li59533/JunYue_Lora/doc/君悦lora_李阳提供文档_20200513/君悦LoRaL100_产品说明书_20200508.docx

文档编号
版本号 | V0.1.0
归档部门

无线温振传感器-L100

【产品说明书】

李 阳

二〇二〇年五月

## 变更记录

序号 | 日期 | 作者/修改者 | 描述 | 版本号
1 | 2020-05-08 | 李阳 | 创建 | 0.0.1
2
3

# 1.引言

## 1.1编写目的

为保证正确使用本产品，要求用户在使用前了解掌握有关正确的安装和操作方法，若阅读本说明后仍有其他疑问请致电本公司技术人员。

## 1.2读者对象

产品实际用户、销售等

## 1.3术语和缩写

术语和缩写 | 解释 | 备注

## 1.4参考资料

参考资料 | 备注

# 2.产品概述

L100无线振动传感器，是一种内置IEPE电路、MEMS电路、温度测量电路，同时提供三轴振动数据的传感器。敏感原理利用无源压电晶体的正压电效应，敏感结构采用先进的剪切结构，通过IEPE电路将压电晶体的输出电荷转换为与振动量成正比的低阻电压信号，经高精度AD采样后，CPU将测得的数据经过算法计算后，通过Lora发送给上位机端。上位机端采集数据的显示与分析。

由于该产品体积小、刚度大、频响宽，电压灵敏度高、寿命长、低阻抗、密封性好、安装可靠、接线使用方便，敏感无源等一系列优点，可广泛应用与航天航空、轨道交通、建筑桥梁、风电监测等工业领域的振动冲击测量。

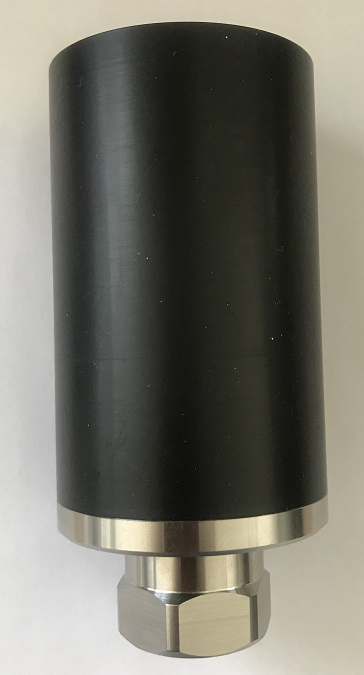
[picture p1: figure]

图1.产品全貌

# 3.产品基本信息

产品名称： 无线温振三轴传感器（Lora）

产品型号： L100

通讯方式： LoRa

默认出厂配置：

休眠时间：60s

SN：L10031001100

有效发送次数：11000次。（4400mAh锂亚电池）

用途：

监测数据：

- 振动加速度有效值(主<500m/s2 ,辅<100m/s2 )
- 振动速度有效值(<35mm/s)
- 振动位移有效值(<560um)
- 峭度(<50)
- 包络(<10)
- 传感器工作温度

性能：

传感器：

- 时域信息存储采样率：16.384KHz
- 采样精度：±0.07m/s2（主轴）±0.15m/s2（辅轴）
- 读取周期：1s
- 通讯协议：私有协议（见通讯协议文档）
- 工作温度：-40℃ to +70℃
- 存储温度：-40℃ to + 85℃
- 待机电流：<10uA
- 工作电流：35mA（采集），150mA（发送）

电源：

  - 工作电压：DC3.6V（锂亚电池）
  - 电池续航能力：发送间隔30min，工作239天（25℃）
  - 锂亚电池说明：
    - 品牌：日月牌锂电池
    - 生产制造商：武汉瀚兴日月电源有限公司
    - 型号：ER14505M（一次锂亚硫酰氯功率型电池3.6V）
    - 标称电量：2.2Ah（两节并联4.4Ah）
    - 标称电压：3.6V
    - 最大连续放电电流：500mA
    - 最大脉冲放电电流：1000mA

振动传感器：

  - 防护等级：IP65
  - 振动量程：±50g（主轴）、±10g（辅轴）
  - 频响：1Hz~5000Hz（主轴）、1Hz~1000Hz（辅轴）
  - 灵敏度：30mv/g（主轴）、132mv/g（辅轴）
  - 隔离方式：与地隔离
  - 传感器类型：IEPE、MEMS

温度传感器：

  - 温度量程：-50~150℃
  - 测温精度：±0.5℃

LoRa传输：

工作频率：470MHz

最大发射功率：20dBm

协议：LoRaWAN

通讯距离：1.5Km（开阔环境）

# 4.产品原理

## 4.1监测单元

主轴振动监测：

L100无线传感器的压电式敏感元件采用P5压电陶瓷晶体，晶体材料在承受一定方向的应力变形时，其极化面会产生与应力相应的电荷。

则有： Q= d F

其中Q为电荷量，d 为压电晶体的压电常数，F为作用力，是施加在晶体上的惯性作用力，根据牛顿第二定律 ：

F=m·a

其中m为惯性质量，a为感受到的加速度

将此公式带入上式，则 Q= d· m·a

在压电晶体的两端输出与加速度成正比的高阻的电荷信号。当压电敏感元件电极表面聚集电荷时，它又相当于一个以压电材料为电介质的电容器。其等效电路如下：

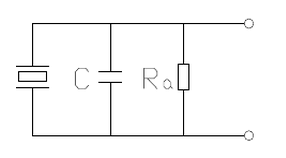
[picture p2: figure]
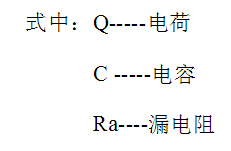
[picture p3: figure]

图2.等效电路

根据以上等效电路，其输出是无源的电荷量。由于压电敏感元件的内阻很高，且信号微弱，需经过二次仪表进行阻抗变换与放大处理后再进入AD采样。通过在无线传感器内部内置IEPE前置电路，将高阻的电荷信号转换成低阻的电压信号，再由内置的CPU采样处理（经滤波、抽样、积分等处理后可测得加速度、速度、位移参量），处理完成后通过LoRa快速发出。

辅轴振动监测：

采用高精度加速度MEMS传感器，进行相对于地面的振动加速度原始数据。经过滤波电路，进入高速AD采样。

温度监测：

采用脉冲式温度传感器采集L100的温度。

## 4.2传输单元

LoRa传输

## 4.3 指示灯单元

- 上电，1s周期慢闪3次。
- 上电回有1min的配置时间，在上电后15s时，会500ms周期快闪3次，提醒此时传感器还有45秒配置时间。
- 休眠前2s会常亮。
- 发送成功，会100ms周期快闪3次。

重发机制：若发送未响应，则会触发重发。

# 5.产品构造与规格

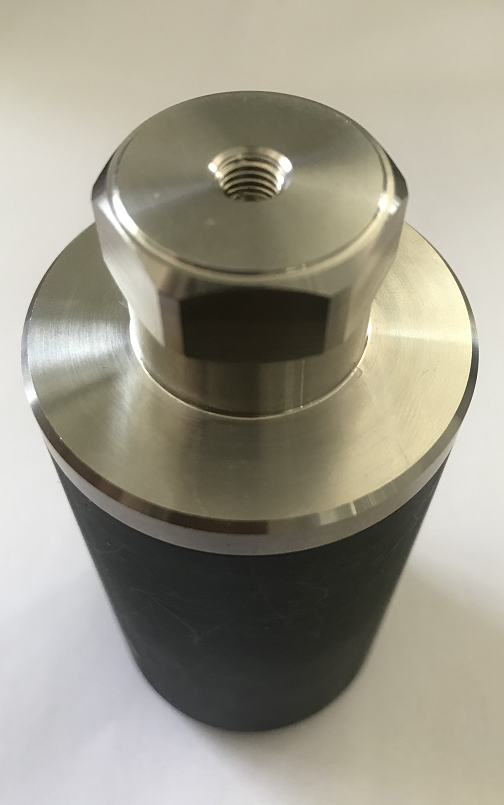
[picture p4: figure]

图3.传感器全貌

尺寸：高150mm，直径50mm

重量：Xg

# 6.产品安装

无线传感器敏感轴（Z轴）为沿垂直于安装底面的方向。正极性是指从安装面指向传感器本体方向收到作用时输出一正极信号，反之输出一负极信号则判断为负极性。

在选择安装方式时要充分考虑每种方法在安装位置、安装附件、环境温度、牢固度等多方面的优缺点，尤其要关注不同的安装方式对加速度传感器的高频性能的影响。

下图为六种主要的安装方法对压电传感器频响产生的典型效果。

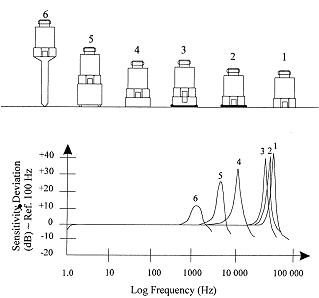
[picture p5: figure]

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
低频性能不受安装方式的影响。截至频率完全取决与内置电路的低频截至频率 。当交流信号耦合时且配接仪表的数量阻抗低于1MΩ时，低频将收到影响。

## 6.1 螺栓安装

由于传感器安装底端面光洁度、平面度均＜1.6μm，希望被测构件与传感器结合面应提高光洁度及平整度，要保证安装面及构件的结合面刚性接触，才能有效地保证达到传感器出厂时的频响特性，因此在被测构件的安装面处，打磨平一块面积约为传感器安装面的1.1倍大，此处的粗糙度要求最好小于0.63um，并清理干净。

在此安装面处图上一层薄薄的油脂，如硅脂等以改善贴合性能。

传感器在底端面有一1/4-28（垂直度＜0.1mm 深6mm）的螺孔。使用时应先将螺栓旋入传感器底部，然后再将传感器安装到被测构件上。建议使用扭矩扳手拧紧传感器，防止出现安装不紧或扭矩过大损坏螺栓或传感器。

## 6.2 胶粘安装

胶粘一般属于临时性安装，或因工件表面无法使用螺栓安装时选用的一种安装方法，一般对高频响应会有影响，对低频影响不大。建议做试样后确定使用频率范围。

可以选用蜂蜡，硅脂等做临时性贴合安装，而采用双组分的环氧胶或快干胶做较为永久性的安装。

胶粘可以通过将传感器先安装在一个转接的安装座上，也可直接安装到工件表面。

## 6.3 磁座安装

磁座安装提供了一种最便捷的快速安装方法，通常在设备状态监控、点检仪以及振动趋势监测等场合。选择合适的磁座和处理好安装面对高频性能是非常关键的。不好的安装会导致高频性能下降50%。

扁平磁座适于光滑平整的表面，而双脚磁座适于有曲面的如管道或电机机壳等安装环境。

在没有磁性或粗糙的安装条件下，建议用户先用焊接或胶粘等方法在测试表面安装一个有光洁平整安装面的钢座，保证测试达到预期效果。

磁座安装时，应禁止磁座安装底面正面直接吸到工件测试表面，防止吸合瞬间产生很大的冲击加速度损坏传感器。而是要先以一点接触安装面后再轻轻转动传感器使安装面贴合。如下图所示。

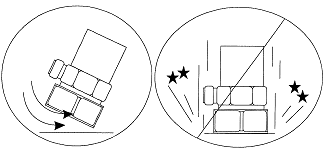
[picture p6: figure]

## 6.4 探针安装

大部分情况下不推荐使用这种安装方式，其在低于5Hz或高于1KHz的情况下均存在极大的误差。仅用于空间受限的设备状态监控场合。

# 7.软件配置

本产品交互报文采用“联能传感器私有协议V1.0.0”，可使用专业软件进行配置。详细配置操作参阅“无线温振传感器配置V1.0.0”。

简要说明：

1. 产品上电1分钟后进入低功耗模式。在存活阶段可用相应的配置软件进行参数配置，如图所示。

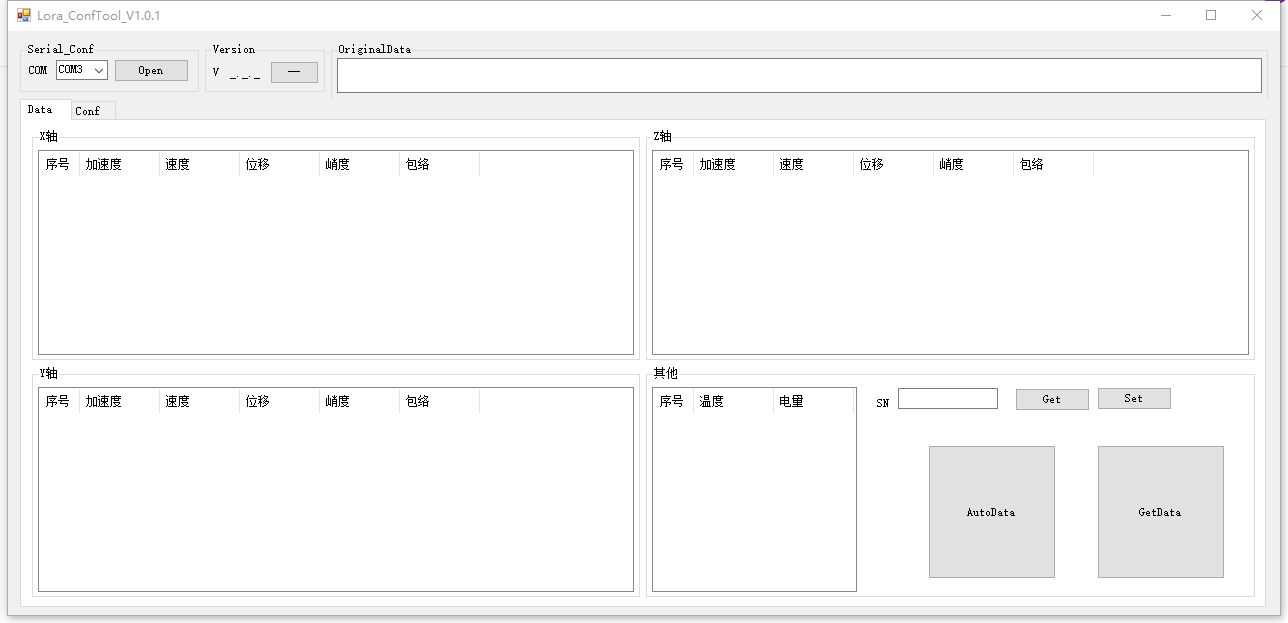
[picture p7: figure]
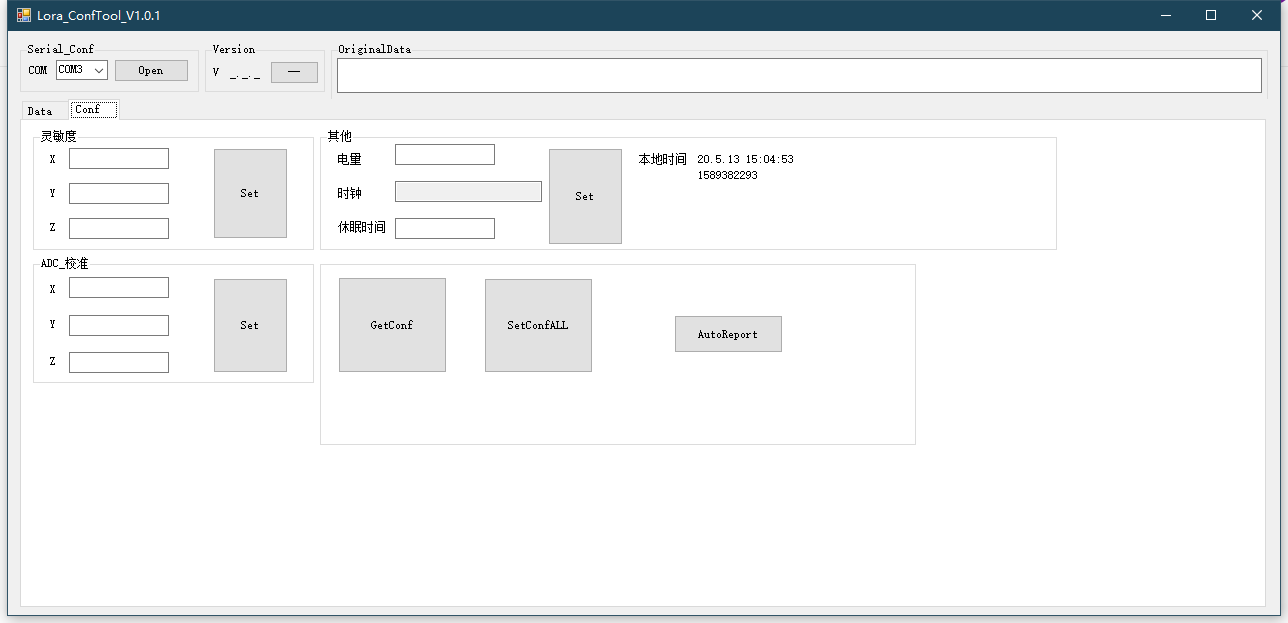
[picture p8: figure]

图4.配置软件说明

注：串口配置软件可修改灵敏度，电量，休眠时间等参数。

# 8.注意事项

1.注意防潮，避免强烈磕碰。

2.产品电池为可更换电池，请在安全环境下，更换指定电池。

3.本产品供电方式存在两种方式，当使用内部电池供电时，需将外部供电接口用配套的密封接口进行密封。当使用外部电源时，需使用隔离器进行隔离。

# 附录：

## 1、 检验机构标志

## 二、防爆合格证号
