li59533/JunYue_Lora/doc/LORA防爆/07.电池及相关/01.ER14505M电池规格书.pdf

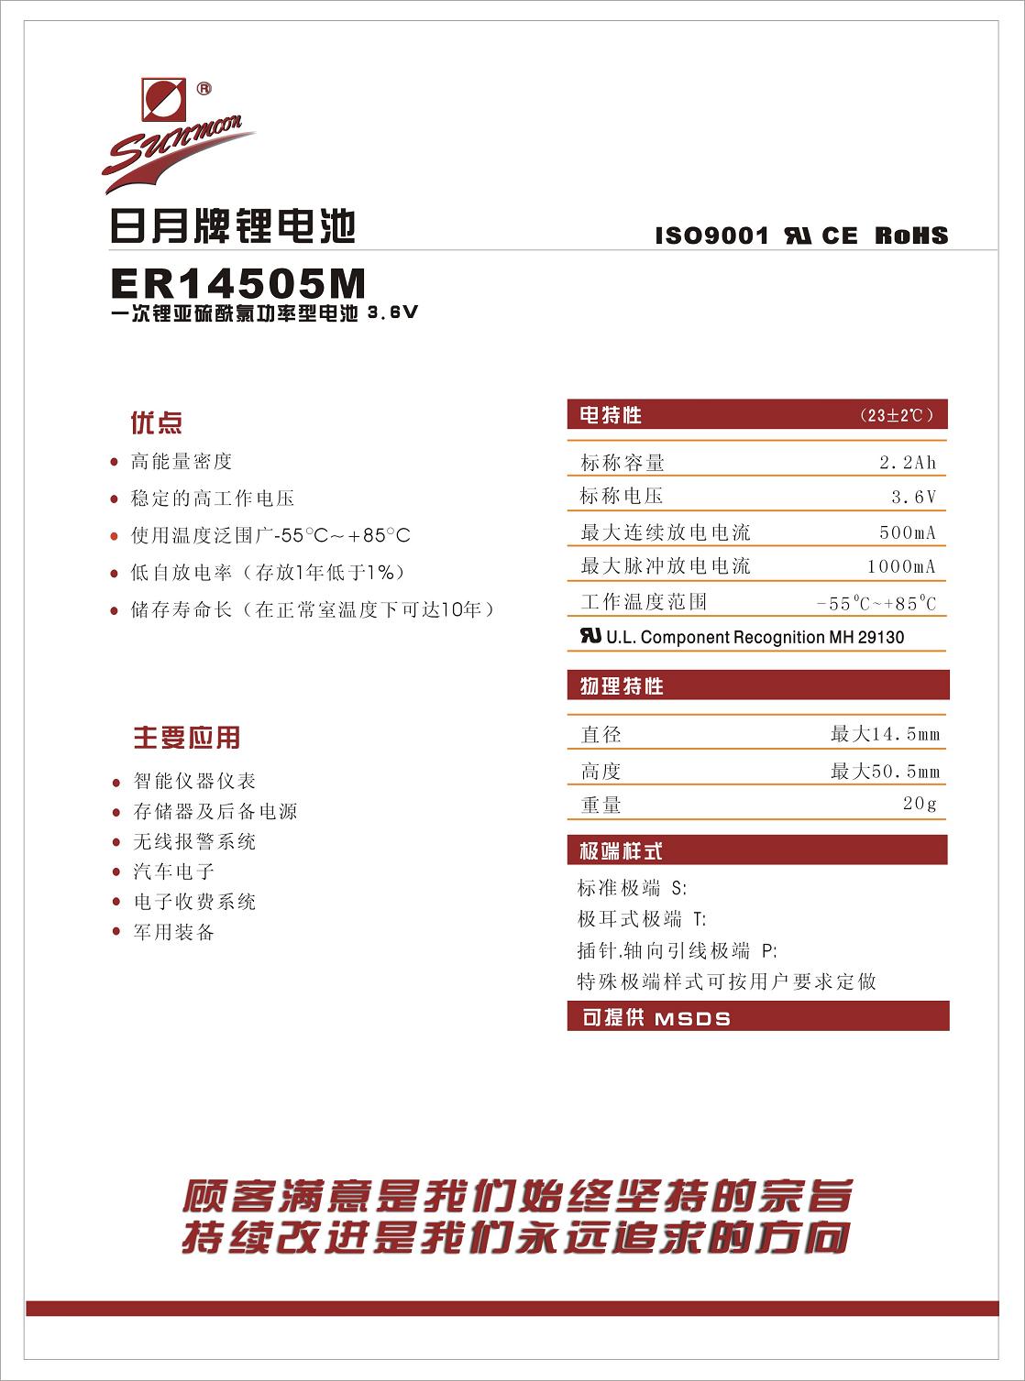
[picture p17: page 1]
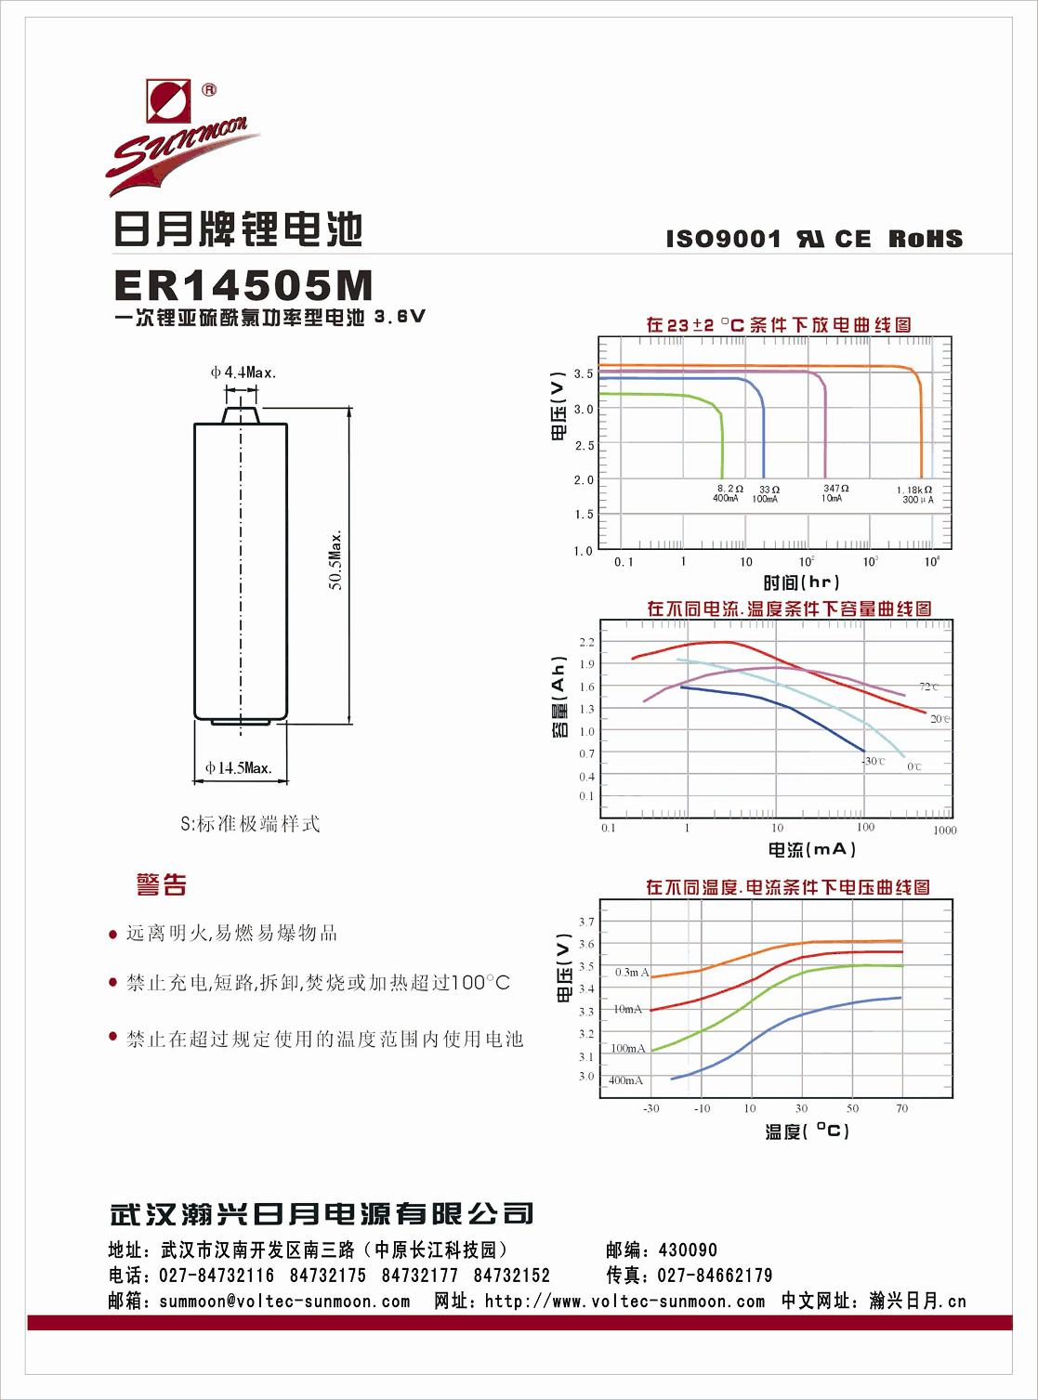
[picture p18: page 2]
