li59533/JunYue_Lora/doc/LORA防爆/10 电源接口/电池插口.bmp

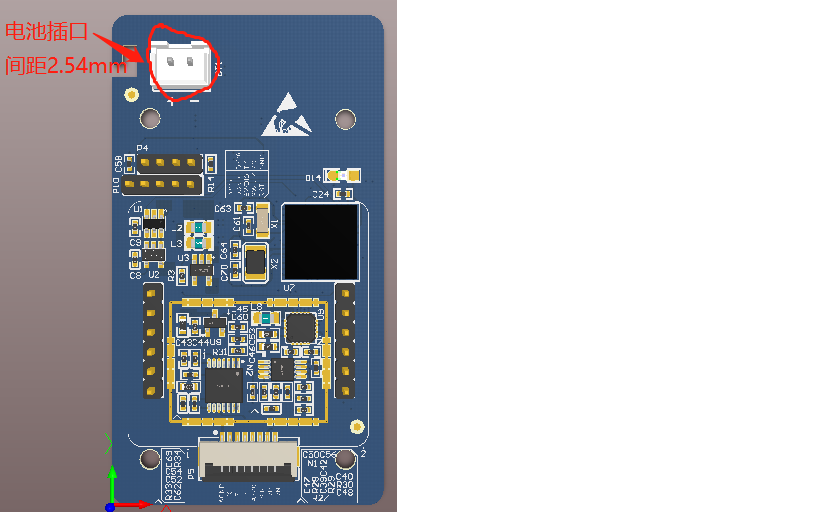
doc/LORA防爆/10 电源接口/电池插口.bmp
