li59533/JunYue_Lora/doc/LORA防爆/08 元器件BOM/L100.xls

Sheet: 限额送料单
_________公司限额送料单
用料车间：_______ | 项目：___________
产品名称：L100
2020年_季度_月份 任务_片 | _ 年_ 月_ 日
材料名称 | 描述 | 单片定额 | 应发数 | 实发数
XH2.54-2P母座 | 2.54间距 | 1
贴片电容，10uF_X5R_10%_10V_0603 | 精度：±10% 容值：10uF 额定电压：10V 温漂系数（介质材料):X5R | 8
贴片电容, 0.1uF_X5R_±10%_10V_0402 | 精度：±10% 容值：100nF 额定电压：10V 温漂系数（介质材料)：X5R | 28
贴片电容，10uF_X5R_20%_10V_1206 | 精度：±10% 容值：100nF 额定电压：10V 温漂系数（介质材料)：X5R | 1
贴片电容，10nF_X7R_10%_10V_0402 | 精度：±10% 容值：10nF 额定电压：10V 温漂系数（介质材料)：X7R | 2
贴片电容，1nF_X5R_10%_10V_0402 | 精度：±5% 容值：1nF 额定电压：10V 温漂系数（介质材料)：NPO | 1
贴片电容, 10uF_X5R_10%_10V_0603 | 精度：±10% 容值：10uF 额定电压：10V 温漂系数（介质材料):X5R | 10
贴片电容,0.1uF_X5R_10%_10V_0603 | 精度：±10% 容值：100nF 额定电压：10V 温漂系数（介质材料)：X5R | 2
贴片电容,1uF_5%_10V_0402 | 精度：5% 容值：1uF 额定电压：10V 温漂系数（介质材料)：X5R | 2
贴片电容,12nF_5%_10V_0402 | 精度：5% 容值：12nF 额定电压：10V 温漂系数（介质材料):X7R | 1
贴片电容,47nF_10V_0402 | 精度：±10% 容值：47nF 额定电压：10V 温漂系数（介质材料)：X5R | 1
贴片电容,6.8nF_10V_0402 | 精度：±10% 容值：6.8nF 额定电压：10V 温漂系数（介质材料）:X7R | 1
贴片电容,3.3nF_10V_0402 | 精度：±10% 容值：3.3nF 额定电压：10V 温漂系数（介质材料）:X7R | 6
贴片电容, 2pF_NPO_5%_50V_0402 | 精度：±0.25pF 容值：2pF 额定电压：50V 温漂系数（介质材料）:NPO | 2
贴片电容, 4.3pF_NPO_5%_50V_0402 | 精度：±0.25pF 容值：4.3pF 额定电压：50V 温漂系数（介质材料):NPO | 2
TOSHIBA,肖特基二极管 SMA,CMS01 | 正向电压0.37V，正向电流3.0A | 1
Default Diode, ESD二极管，ESD5Z3V3 | 反向关断电压（典型值）：3.3V 击穿电压（最小值）：5V 钳位电压：14V 峰值脉冲电流：7.5A | 3
贴片LED，蓝灯，0805 | 蓝色 主波长/色坐标：465~470nm 超亮 | 1
自恢复保险丝，ASMD1206-100，1206 | 最大电压：6V 跳断电阻值(Max)：270mΩ 跳闸电流：1.8A 最大动作时间：300ms | 1
精密运放，OPA2313IDGKR，MSOP8_M | 增益带宽积（GBP）：1MHz 放大器组数：2 各通道功耗：50uA 压摆率（SR）:0.5V/us 电源电源1.8～5.5V | 1
4运放，OPA4171AIPWR，TSSOP14_L | 增益带宽积（GBP）：3MHz 放大器组数：4 各通道功耗：474uA 压摆率（SR）:1.5V/us 电源电压：2.7～36V.±1.35～18V | 1
2.54间距排针，单排双塑，1*6P，针长11.5MM | NC | 2
2.0间距排针，单排单塑，1*4P，针长11.5MM | NC | 1
FPC连接器 FPC1.0-2H-WS-8P 伍尔特 物料编号：68610814122 | NC | 1
WR-FFC软排线 伍尔特 物料编号：686708050001 | NC | 2
屏蔽夹 6.5*0.8*1.2 | NC | 12
2.0间距排针，单排单塑，1*4P，针长11.5MM | NC | 1
三极管_NPN,MMBT3904,SOT23-3N | 额定功率：200mW 集电极电流Ic：200mA 集射极击穿电压VCE：40V 晶体管类型：NPN Vceo=40V | 1
贴片电阻,1M_5%_0402 | 阻值（欧姆）：1M 精度：±5% 功率：1/16W 温度系数：±100ppm/℃ | 4
贴片电阻,0_5%_0805 | 阻值（欧姆）：0 精度：±1% 功率：1/8W 温度系数:-200ppm/℃～+400ppm/℃ | 1
贴片电阻,10K_1%_0402 | 阻值（欧姆）：10K 精度：±1% 功率：1/16W 温度系数：±100ppm/℃ | 6
贴片电阻,100K_1%_0402 | 阻值（欧姆）：100K 精度：±0.5% 功率：1/16W 温度系数：±100ppm/℃ | 1
贴片电阻,7.5K_1%_0402 | 阻值（欧姆）：7.5K 精度：±1% 功率：1/16W 温度系数:±100ppm/℃ | 1
贴片电阻,0_1%_0402 | 阻值（欧姆）：15K 精度：±1% 功率：1/16W 温度系数：±100ppm/℃ | 3
贴片电阻,2.05K_1%_0402 | 阻值（欧姆）：2.05K 精度：±1% 功率：1/16W 温度系数：±100ppm/℃ | 1
贴片电阻,2.8K_1%_0402 | 阻值（欧姆）：2.8K 精度：±1% 功率：1/16W 温度系数：±100ppm/℃ | 1
贴片电阻,1.33K_1%_0402 | 阻值（欧姆）：1.33K 精度：±1% 功率：1/16W 温度系数：±100ppm/℃ | 1
贴片电阻,1.65K_1%_0402 | 阻值（欧姆）：1.65K 精度：±1% 功率：1/16W 温度系数：±100ppm/℃ | 1
贴片电阻,32K_1%_0402 | 阻值（欧姆）：32K 精度：±1% 功率：1/16W 温度系数：±100ppm/℃ | 3
贴片电阻,5.1k_5%_0402 | 阻值（欧姆）：5.1K 精度：±1% 功率：1/16W 温度系数：±100ppm/℃ | 1
超低泄漏负载开关,TPS22917DBVR,SOT23-6 | 输入工作电压范围：1V～5.5V 最大持续电流（Imax）：2A 导通电阻：5V（80mΩ典型值1.8V（120mΩ）典型值 1V（220mΩ）典型值 超低功耗：ON(Iq):0.5uA(典型值) OFF（Isd）：10nA | 1
低压差700mVLDO,SPX3819M5-L-3.0V,SOT23-5 | 输出电流：500mA 输出类型：Adjustable 最大输入电压：16V 输出电压：（最小值/固定值）：1.235V 可调节输出：（1.235V～15.3V），低压差700mV@Iout=500mA,Vin=16V(Max) | 1
线性电源，XC6209B302MR-G,SOT23-5N | 输出电流：200mA 输出类型：Fixed 最大输入电压：6V 输出电压（最小值/固定值）：3.3V 固定输出：Iout=200mA,vin=6V(max) | 1
ARM微控制器，STM32L4R9ZIJ6，UFBGA144 | ARM Cortex M4 数据总线宽度：32bit 最大时钟频率：120MHz 程序存储器大小：2MB 数据RAM大小：640KB 工作电压：1.71 V to 3.6 V 工作温度范围：-40℃～85℃ | 1
TI参考电压1.25V，REF3325AIDBZR，SOT23-3N | 输出电压（最小值/固定）：3V±0.15% 输出电流：5mA 温度系数：30ppm/℃ | 1
ADI数模转换器，AD7682BCPZRL71，LFCSP-20 | 16位，4通道，吞吐速率：250ksps INL:典型值：±0.4LSB，最大值：±1.5LSB（±23PPM或FSR），动态范围93.8 dB SINAD：92.5 dB (20 kHz)THD：−100 dB(20 kHz) ，轨到轨，功耗：3.5 mW(2.5 V/200 kSPS) 12.5 mW(5 V/250 kSPS)待机电流：50 nA | 1
线性LDO,XC6206P332MR，SOT23-3N | 输出电流：200mA 输出类型：Fixed 最大输入电压：6V 输出电压（最小值/固定值）：3.3V 固定输出：Iout=200mA,vin=6V(max) | 1
无源晶振32.768KHz 10ppm，NX3215SA-32.768KHZ-EXS00A-MU00525，OSC 3215-2P | 等效串联电阻（ESR）：80kΩ 主频：32.768KHz 频率公差：±20ppm/℃ 负载电容值：12.5pF | 1
NDK无源晶振8MHz，NX3225GD-8MHZ-STD-CRA-3，OSC 3225-2P | 等效串联电阻（ESR）：- 主频：8MHz 频率公差：±20ppm/℃ 负载电容值：12pF | 1
加速度计，KXD94-2802，LFDFN-14 | 工作电压：2.5～5.25V 工作温度范围：-40℃～85℃ 灵敏度：193mv/g～207mv/g 满量程;±10g | 1
TI基准芯片，REF3312AIDBZR，SOT23-3N | 输出电压（最小值/固定）：1.25V 输出电流：30mA 输出电压（ 最大值）温度系数：30ppm/℃ 参考源类型：1.25V | 1
SMA 偏脚射频天线座 1.6mm | nc | 1
Lora模块 LoRaWAN LM78 天津中科智城网络技术有限公司 LM78 | nc | 1
弹簧天线（另购） | nc | 1
电池ER14505，瀚兴日月，见电池工艺尺寸 | nc | 1
凸型屏蔽罩：见屏蔽罩尺寸 | nc | 1
方型屏蔽罩：见屏蔽罩尺寸 | nc | 1
PCB：LQC7.820.2901-20 板厚1.6mm FR4板材 4层板 绿油白字 | nc | 1
PCB:LQC7.820.2800-20 板厚1.6mm FR4板材 2层板 绿油白字 | nc | 1
LQC7.820.2901-6 板厚1.6mm FR4板材 2层板 绿油白字 | nc | 1

Sheet: 贴片位号表
型号数值 | 位号
LQC7.820.2901-20
贴片电容，10uF_X5R_10%_10V_0603 | C1,C6
贴片电容, 0.1uF_X5R_±10%_10V_0402 | C3, C5, C11, C24, C25, C27, C28, C29, C30, C32, C33, C34, C35, C41, C42, C44, C45, C50, C51, C54, C56, C57, C58, C59
贴片电容，10uF_X5R_20%_10V_1206 | C7
贴片电容，10nF_X7R_10%_10V_0402 | C8, C47
贴片电容，1nF_X5R_10%_10V_0402 | C9
贴片电容, 10uF_X5R_10%_10V_0603 | C13, C43, C46, C49, C53,C52
贴片电容,0.1uF_X5R_10%_10V_0603 | C12, C16
贴片电容,1uF_5%_10V_0402 | C26, C31，C17
贴片电容,12nF_5%_10V_0402 | C39
贴片电容,47nF_10V_0402 | C40
贴片电容,6.8nF_10V_0402 | C48
贴片电容,3.3nF_10V_0402 | C60, C62, C69
贴片电容, 2pF_NPO_5%_50V_0402 | C61, C63
贴片电容, 4.3pF_NPO_5%_50V_0402 | C64, C70
TOSHIBA,肖特基二极管 SMA,CMS01 | D1
Default Diode, ESD二极管，ESD5Z3V3 | D3, D4, D6
贴片LED，蓝灯，0805 | D14
自恢复保险丝，ASMD1206-100，1206 | F1
精密运放，OPA2313IDGKR，MSOP8_M | N1
4运放，OPA4171AIPWR，TSSOP14_L | N2
2.0间距排针，单排单塑，1*4P，针长11.5MM | P4
FPC连接器 FPC1.0-2H-WS-8P 伍尔特 物料编号：68610814122 | P5
屏蔽夹 6.5*0.8*1.2 | P6, P7, P8, P11, P12, P13
2.0间距排针，单排单塑，1*4P，针长11.5MM | P10
三极管_NPN,MMBT3904,SOT23-3N | Q2
贴片电阻,1M_5%_0402 | R1，R3
贴片电阻,0_5%_0805 | R6
贴片电阻,10K_1%_0402 | R10, R11, R13, R14, R26, R32
贴片电阻,100K_1%_0402 | R20
贴片电阻,7.5K_1%_0402 | R21
贴片电阻,0_1%_0402 | R23,R24, R25,R201,R202,R203
贴片电阻,2.05K_1%_0402 | R27
贴片电阻,2.8K_1%_0402 | R28
贴片电阻,1.33K_1%_0402 | R29
贴片电阻,1.65K_1%_0402 | R30
贴片电阻,32K_1%_0402 | R31, R33, R34
贴片电阻,5.1k_5%_0402 | R60
超低泄漏负载开关,TPS22917DBVR,SOT23-6 | U1
低压差700mVLDO,SPX3819M5-L-3.0V,SOT23-5 | U2
线性电源，XC6209B302MR-G,SOT23-5N | U3
ARM微控制器，STM32L4R9ZIJ6，UFBGA144 | U7
TI参考电压1.25V，REF3325AIDBZR，SOT23-3N | U8
ADI数模转换器，AD7682BCPZRL71，LFCSP-20 | U9
线性LDO,XC6206P332MR，SOT23-3N | U13
无源晶振32.768KHz 10ppm，NX3215SA-32.768KHZ-EXS00A-MU00525，OSC 3215-2P | X1
NDK无源晶振8MHz，NX3225GD-8MHZ-STD-CRA-3，OSC 3225-2P | X2
LQC7.820.2800-20
贴片电容,3.3nF_X5R_10%_10V_0402 | C1, C2, C3
贴片电容，0.1uF_X5R_±10%_10V_0402 | C4
贴片电容，10uF_X5R_10%_10V_0603 | C5, C8, C30, C32
加速度计，KXD94-2802，LFDFN-14 | N1
贴片电阻,0_1%_0402 | R204
FPC连接器 FPC1.0-2H-WS-8P 伍尔特 物料编号：68610814122 | P2
屏蔽夹 6.5*0.8*1.2 | P6, P7, P8, P11, P13
XH2.54-2P母座 | BT1
TI基准芯片，REF3312AIDBZR，SOT23-3N | U1
LQC7.820.2901-6
贴片电容，10uF_X5R_10%_10V_0603， | C3
贴片电容, 0.1uF_X5R_±10%_10V_0402 | C9
2.54间距排针，单排双塑，1*6P，针长11.5MM | P1, P2
SMA 偏脚射频天线座 1.6mm | （NC）
贴片电阻，1M_5%_0402 | R2, R5
Lora模块 LoRaWAN LM78 天津中科智城网络技术有限公司 LM78 | U2
