li59533/JunYue_Lora/doc/PCB20200119/BOM/君悦LORA .xls

Sheet: 限额送料单
江苏联能电子技术有限公司限额送料单
用料车间：系统车间 | 项目：
产品名称：君悦LORA
2019年4季度10月份 任务35片 | 2019.10.18
材料名称 | 单片定额 | 应发数 | 实发数
主板 LQC7.820.2901-LORA
贴片电容-10uF_X5R_10%_10V_0603 | 6 | 210
贴片电容-0.1uF_X5R_10%_10V_0603 | 24 | 840
贴片电容-100uF_X5R_20%_6.3V_1206 | 2 | 70
贴片电容-10nF_X7R_10%_10V_0603 | 1 | 35
贴片电容-1nF_X7R_10%_10V_0603 | 3 | 105
贴片电容-1uF_X5R_10%_10V_0603 | 9 | 315
贴片电容-100nF_X5R_10%_10V_0402 | 1 | 35
贴片电容-10uF_X5R_10%_10V_0402 | 2 | 70
贴片电容-2pF_NPO_5%_50V_0603 | 2 | 70
贴片电容-4.3pF_NPO_5%_50V_0603 | 2 | 70
贴片LED 蓝灯1206 | 1 | 35
ESD二极管-ESD5Z3V3-SOD-523 | 1 | 35
固定电感器-LB2012T2R2M-0805 | 3 | 105
TDK固定电感器-MLZ2012N100L-10uH-0805 | 2 | 70
接插件-HDR2.0-LI-4P | 2 | 70
SMA 偏脚射频天线座 1.6mm 伍尔特 物料单号:60312202114509 | 1 | 35
接插件-HDR2.0-LI-5P | 1 | 35
FPC连接器 FPC1.0-2H-WS-8P 伍尔特 物料编号：68610814122 | 1 | 35
三极管_NPN-MMBT3904-SOT23-3N | 1 | 35
贴片电阻-1M_5%_0603 | 6 | 210
贴片电阻-510_5%_0603 | 1 | 35
贴片电阻-0_1%_0603 | 8 | 280
贴片电阻-100K_1%_0603 | 1 | 35
贴片电阻-7.5K_1%_0603 | 1 | 35
贴片电阻-10K_5%_0603 | 2 | 70
1V 至 5.5V、2A、80mΩ 超低泄漏负载开关-TPS22917DBVR-SOT23-6 | 3 | 105
低压差700mVLDO-SPX3819M5-L-3.0V,SOT23-5 | 1 | 35
Lora模块 LoRaWAN LM78 天津中科智城网络技术有限公司 LM78 | 1 | 35
低压差线性稳压(LDO)-XC6206P332MR,SOT23 | 2 | 70
基准电源芯片-REF3330AIDBZR-SOT23-3N | 1 | 35
ADI数模转换器-AD7682BCPZRL71-LFCSP-20 | 1 | 35
低压差线性稳压(LDO)-XC6209B302MR-G，SOT23-5 | 1 | 35
MCU-STM32L4R9ZIJ6-UFBGA144 | 1 | 35
无源晶振--NX3215SA,32.768KHZ,EXS00A-MU00525,OSC 3215-2P | 1 | 35
WR-FFC软排线 伍尔特 物料编号：686608050001 1 25 | 1 | 35
PH2.0-2P弯角插座 母头带线10CM 伍尔特 物料编号：62000211622（座） 620002113322（插头） 2 50 | 1 | 35
无源晶振--NX3215SA,32.768KHZ,EXS00A-MU00525,OSC 3215-2P | 1 | 35
PCB:LQC7.820.2901-LORA 4层板 1.6mm 绿油白字 | 1 | 35
底板 LQC7.820.2800-LORA
贴片电容-12nF_5%_10V_0603 | 1 | 35
贴片电容-68nF_10V_0603 | 1 | 35
贴片电容-10uF_X5R_10%_10V_0603 | 2 | 70
贴片电容-2.2uF_10%_6.3V_0603 | 1 | 35
贴片电容-10nF_5%_10V_0603 | 2 | 70
贴片电容-0.1uF_5%_10V_0603 | 5 | 175
贴片电容-10nF_X5R_10%_10V_0603 | 3 | 105
贴片电容-22nF_X5R_10%_10V_0603 | 3 | 105
贴片电容-3.3nF_X5R_10%_10V_0603 | 3 | 105
精密运放-OPA2313IDGKR-MSOP8_M | 1 | 35
贴片集成电路-OPA4171AIPWR-TSSOP14_L | 1 | 35
加速度计-KXD94-2802-LFDFN-14 | 1 | 35
FPC连接器 FPC1.0-2H-WS-8P 伍尔特 物料编号：68610814122 | 1 | 35
贴片电阻-15K_1%_0603 | 1 | 35
贴片电阻-12K_1%_0603 | 1 | 35
贴片电阻-5.6K_1%_0603 | 5 | 175
贴片电阻-499K_1%_0603 | 1 | 35
贴片电阻-3k_1%_0603 | 3 | 105
基准芯片-ISL21080CIH315Z-TK | 1 | 35
PCB:LQC7.820.2800-LORA 4层板 1.6mm 绿油白字 | 1 | 35

Sheet: 位号表
型号数值 | 位号
主板 LQC7.820.2901-LORA
贴片电容-10uF_X5R_10%_10V_0603 | C1, C11, C19, C21, C22, C26
贴片电容-0.1uF_X5R_10%_10V_0603 | C2, C12, C20, C27,C17, C34, C38, C40, C42, C45, C46, C47, C49, C50, C51, C52, C59, C67, C68, C70, C74
贴片电容-100uF_X5R_20%_6.3V_1206 | C3, C5
贴片电容-10nF_X7R_10%_10V_0603 | C4
贴片电容-1nF_X7R_10%_10V_0603 | C13, C23, C44
贴片电容-1uF_X5R_10%_10V_0603 | C18, C31, C32, C36, C37, C41, C48, C75,C35
贴片电容-100nF_X5R_10%_10V_0402 | C33
贴片电容-10uF_X5R_10%_10V_0402 | C39, C43
贴片电容-2pF_NPO_5%_50V_0603 | C72, C73
贴片电容-4.3pF_NPO_5%_50V_0603 | C77, C79
贴片LED 蓝灯1206 | D2
ESD二极管-ESD5Z3V3-SOD-523 | D4
固定电感器-LB2012T2R2M-0805 | L5, L6, L9
TDK固定电感器-MLZ2012N100L-10uH-0805 | L7, L8
接插件-HDR2.0-LI-4P | P1, P2
SMA 偏脚射频天线座 1.6mm 伍尔特 物料单号:60312202114509 | P3
接插件-HDR2.0-LI-5P | P4
FPC连接器 FPC1.0-2H-WS-8P 伍尔特 物料编号：68610814122 | P5
三极管_NPN-MMBT3904-SOT23-3N | Q2
贴片电阻-1M_5%_0603 | R2, R3, R4, R5, R17，R1
贴片电阻-510_5%_0603 | R9
贴片电阻-0_1%_0603 | R10, R11, R12, R18, R19, R20，R13，R15
贴片电阻-100K_1%_0603 | R14
贴片电阻-7.5K_1%_0603 | R16
贴片电阻-10K_5%_0603 | R21, R29
1V 至 5.5V、2A、80mΩ 超低泄漏负载开关-TPS22917DBVR-SOT23-6 | U1, U6, U9
低压差700mVLDO-SPX3819M5-L-3.0V,SOT23-5 | U2
Lora模块 LoRaWAN LM78 天津中科智城网络技术有限公司 LM78 | U3
低压差线性稳压(LDO)-XC6206P332MR,SOT23 | U5, U13
基准电源芯片-REF3330AIDBZR-SOT23-3N | U7
ADI数模转换器-AD7682BCPZRL71-LFCSP-20 | U8
低压差线性稳压(LDO)-XC6209B302MR-G，SOT23-5 | U10
MCU-STM32L4R9ZIJ6-UFBGA144 | U11
无源晶振--NX3215SA,32.768KHZ,EXS00A-MU00525,OSC 3215-2P | X1
NDK无源晶振-NX3225GD-OSC 3225-2P NX3215SA-32.768KHZ-EXS00A-MU00525 | X2
底板 LQC7.820.2800-LORA
贴片电容-12nF_5%_10V_0603 | C1
贴片电容-68nF_10V_0603 | C2
贴片电容-10uF_X5R_10%_10V_0603 | C3，C10
贴片电容-2.2uF_10%_6.3V_0603 | C7
贴片电容-10nF_5%_10V_0603 | C8，C9
贴片电容-0.1uF_5%_10V_0603 | C11，C4, C5, C6,C17
贴片电容-10nF_X5R_10%_10V_0603 | C12, C18, C20
贴片电容-22nF_X5R_10%_10V_0603 | C13, C19, C21
贴片电容-3.3nF_X5R_10%_10V_0603 | C14, C15，C16
精密运放-OPA2313IDGKR-MSOP8_M | N1
贴片集成电路-OPA4171AIPWR-TSSOP14_L | N2
加速度计-KXD94-2802-LFDFN-14 | N3
FPC连接器 FPC1.0-2H-WS-8P 伍尔特 物料编号：68610814122 | P2
贴片电阻-15K_1%_0603 | R1
贴片电阻-12K_1%_0603 | R2
贴片电阻-5.6K_1%_0603 | R3, R4, R6, R8, R10
贴片电阻-499K_1%_0603 | R5
贴片电阻-3k_1%_0603 | R7, R9, R11
基准芯片-ISL21080CIH315Z-TK | U1
