li59533/JunYue_Lora/code/stm32l4xx/stm32l4xx/projects/stm32l4xx/changelog.txt

-----------------------
**发布时间：**2020.1.2
**代码地址：**https://github.com/li59533/JunYue_Lora.git
**版本：**V0.1.4
**说明：**
	1.上电2min内，不会休眠。
	2.当休眠时间为0时，不会休眠。
	3.不休眠时，每隔10s上报数据。
	4.支持串口配置。

**更新内容：**

_删除：_
		无
_新增：_
		无
_修改：_
		1.修复串口接收错位bug
		
-----------------------
-----------------------
**发布时间：**2019.12.16
**代码地址：**https://github.com/li59533/JunYue_Lora.git
**版本：**V0.1.3
**说明：**
	1.上电2min内，不会休眠。
	2.当休眠时间为0时，不会休眠。
	3.不休眠时，每隔10s上报数据。
	4.支持串口配置。

**更新内容：**

_删除：_
		无
_新增：_
		1.lora模块3s没有数据返回，lora模块重新上电
_修改：_
		无
		
-----------------------
-----------------------
**发布时间：**2019.12.11
**代码地址：**https://github.com/li59533/JunYue_Lora.git
**版本：**V0.1.2
**说明：**
	1.上电2min内，不会休眠。
	2.当休眠时间为0时，不会休眠。
	3.不休眠时，每隔10s上报数据。
	4.支持串口配置。

**更新内容：**

_删除：_
		无
_新增：_
		无
_修改：_
		无
		
-----------------------
-----------------------
**发布时间：**2019.11.29
**代码地址：**https://github.com/li59533/JunYue_Lora.git
**版本：**V0.0.1
**说明：**

**更新内容：**

_删除：_
		无
_新增：_
		无
_修改：_
		无
		
-----------------------
