li59533/JunYue_Lora/doc/君悦LORA振动传感器_硬件BUG记录_20191120.xlsx

L100-BUG记录
日期：2019.11.20
 |  |  | 软件版本 |  | 硬件版本 | V0.0.1
硬件
序号 | BUG说明 | 修改说明 | 发现时间 | 修正时间 | 指派 | 状态 | 备注
1 | 下载口没有丝印 | 推荐加上丝印，并且同一类型的下载口（串口等）的始终使用同样的排线顺序 | 2019-11-20 |  | 陈尧 | 待解决
2 | MCU和LORA的串口接错了，RX接RX，TX接TX了
 | wifi和lora的串口2不是默认的串口2， 需要重映射，改版的时候改一下
软件
序号 | BUG说明 | 修改说明 | 发现时间 | 修正时间 | 指派 | 状态 | 备注
1
2
3
4
5
结构
序号 | BUG说明 | 修改说明 | 发现时间 | 修正时间 | 指派 | 状态 | 备注
