li59533/JunYue_Lora/doc/主板20200427.pdf

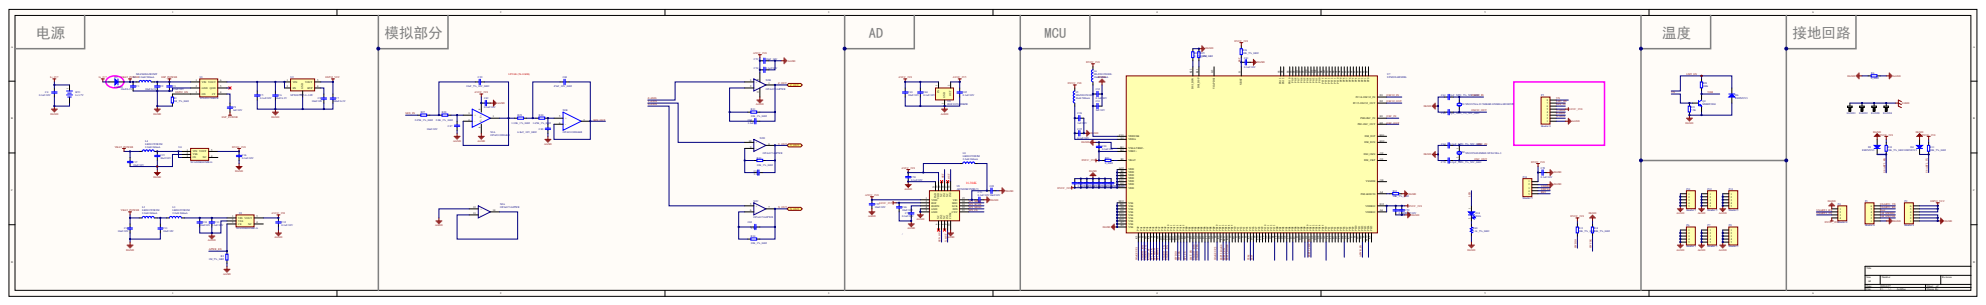
[picture p20: page 1]

IN0 16 NC 17 IN1 18 NC 19 VDD 20 PAD 21

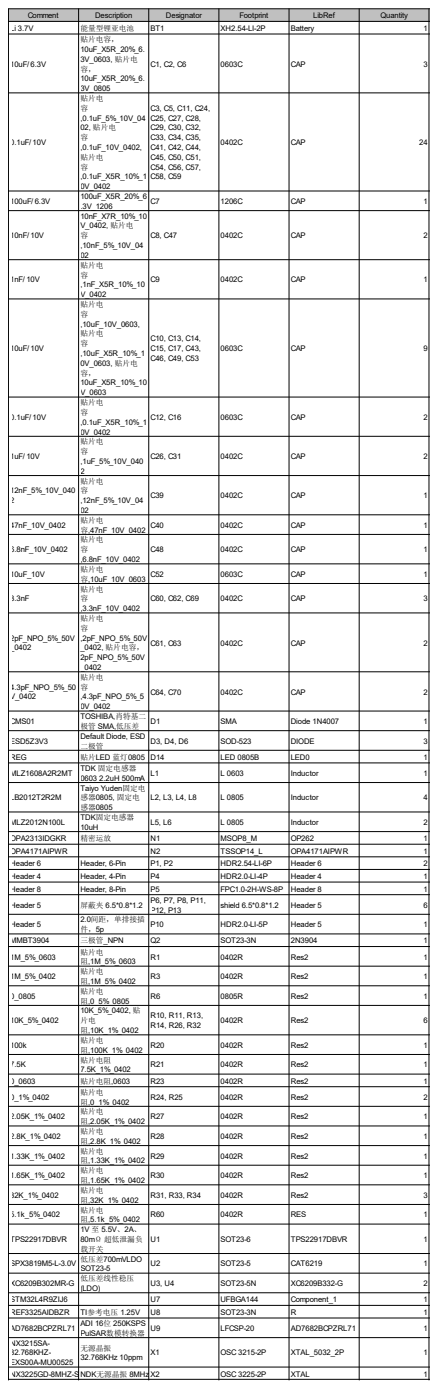
[picture p21: page 2]

Comment | Description | Designator | Footprint | LibRef | Quantity
Li 3.7V | 能量型锂亚电池 | BT1 | XH2.54-LI-2P | Battery | 1
10uF/ 6.3V | 贴片电容， 10uF_X5R_20%_6. 3V_0603, 贴片电 容， 10uF_X5R_20%_6. 3V_0805 | C1, C2, C6 | 0603C | CAP | 3

0.1uF/ 10V | 贴片电 容 ,0.1uF_5%_10V_04 02, 贴片电 容 ,0.1uF_10V_0402, 贴片电 容 ,0.1uF_X5R_10%_1 0V_0402 | C3, C5, C11, C24, C25, C27, C28, C29, C30, C32, C33, C34, C35, C41, C42, C44, C45, C50, C51, C54, C56, C57, C58, C59 | 0402C | CAP | 24

100uF/ 6.3V | 100uF_X5R_20%_6 .3V_1206 | C7 | 1206C | CAP | 1

10nF/ 10V | 10nF_X7R_10%_10 V_0402, 贴片电 容 ,10nF_5%_10V_04 02 | C8, C47 | 0402C | CAP | 2

1nF/ 10V | 贴片电 容 ,1nF_X5R_10%_10 V_0402 | C9 | 0402C | CAP | 1

10uF/ 10V | 贴片电 容 ,10uF_10V_0603, 贴片电 容 ,10uF_X5R_10%_1 0V_0603, 贴片电 容， 10uF_X5R_10%_10 V_0603 | C10, C13, C14, C15, C17, C43, C46, C49, C53 | 0603C | CAP | 9

0.1uF/ 10V | 贴片电 容 ,0.1uF_X5R_10%_1 0V_0402 | C12, C16 | 0603C | CAP | 2

1uF/ 10V | 贴片电 容 ,1uF_5%_10V_040 2 | C26, C31 | 0402C | CAP | 2

12nF_5%_10V_040 2 | 贴片电 容 ,12nF_5%_10V_04 02 | C39 | 0402C | CAP | 1

47nF_10V_0402 | 贴片电 容 ,47nF_10V_0402 | C40 | 0402C | CAP | 1

6.8nF_10V_0402 | 贴片电 容 ,6.8nF_10V_0402 | C48 | 0402C | CAP | 1

10uF_10V | 贴片电 ,10uF_10V_0603 容 | C52 | 0603C | CAP | 1

3.3nF | 贴片电 容 ,3.3nF_10V_0402 | C60, C62, C69 | 0402C | CAP | 3

2pF_NPO_5%_50V _0402 | 贴片电 容 ,2pF_NPO_5%_50V _0402, 贴片电容， 2pF_NPO_5%_50V _0402 | C61, C63 | 0402C | CAP | 2

4.3pF_NPO_5%_50 V_0402 | 贴片电 容 ,4.3pF_NPO_5%_5 0V_0402 | C64, C70 | 0402C | CAP | 2

CMS01 | 肖特基二 TOSHIBA, SMA, 极管 低压差 | D1 | SMA | Diode 1N4007 | 1

ESD5Z3V3 | Default Diode, ESD 二极管 | D3, D4, D6 | SOD-523 | DIODE | 3

REG | 贴片 LED 蓝灯 0805 | D14 | LED 0805B | LED0 | 1
MLZ1608A2R2MT | TDK 0603 2.2uH 500mA 固定电感器 | L1 | L 0603 | Inductor | 1

LB2012T2R2M | Taiyo Yuden 固定电 感器 0805, 固定电 感器 0805 | L2, L3, L4, L8 | L 0805 | Inductor | 4

MLZ2012N100L | TDK 固定电感器 10uH | L5, L6 | L 0805 | Inductor | 2

OPA2313IDGKR | 精密运放 | N1 | MSOP8_M | OP262 | 1
OPA4171AIPWR | | N2 | TSSOP14_L | OPA4171AIPWR | 1
Header 6 | Header, 6-Pin | P1, P2 | HDR2.54-LI-6P | Header 6 | 2
Header 4 | Header, 4-Pin | P4 | HDR2.0-LI-4P | Header 4 | 1
Header 8 | Header, 8-Pin | P5 | FPC1.0-2H-WS-8P | Header 8 | 1
Header 5 | 屏蔽夹 6.5*0.8*1.2 | P6, P7, P8, P11, P12, P13 | shield 6.5*0.8*1.2 | Header 5 | 6

Header 5 | 2.0 间距，单排接插 5p 件， | P10 | HDR2.0-LI-5P | Header 5 | 1

MMBT3904 | 三极管 _NPN | Q2 | SOT23-3N | 2N3904 | 1
1M_5%_0603 | 贴片电 ,1M_5%_0603 阻 | R1 | 0402R | Res2 | 1

1M_5%_0402 | 贴片电 ,1M_5%_0402 阻 | R3 | 0402R | Res2 | 1

0_0805 | 贴片电 阻 ,0_5%_0805 | R6 | 0805R | Res2 | 1

10K_5%_0402 | 10K_5%_0402, 贴 片电 阻 ,10K_1%_0402 | R10, R11, R13, R14, R26, R32 | 0402R | Res2 | 6

100k | 贴片电 ,100K_1%_0402 阻 | R20 | 0402R | Res2 | 1

7.5K | 贴片电阻 7.5K_1%_0402 | R21 | 0402R | Res2 | 1

0_0603 | 贴片电阻 ,0603 | R23 | 0402R | Res2 | 1
0_1%_0402 | 贴片电 阻 ,0_1%_0402 | R24, R25 | 0402R | Res2 | 2

2.05K_1%_0402 | 贴片电 ,2.05K_1%_0402 阻 | R27 | 0402R | Res2 | 1

2.8K_1%_0402 | 贴片电 阻 ,2.8K_1%_0402 | R28 | 0402R | Res2 | 1

1.33K_1%_0402 | 贴片电 阻 ,1.33K_1%_0402 | R29 | 0402R | Res2 | 1

1.65K_1%_0402 | 贴片电 ,1.65K_1%_0402 阻 | R30 | 0402R | Res2 | 1

32K_1%_0402 | 贴片电 阻 ,32K_1%_0402 | R31, R33, R34 | 0402R | Res2 | 3

5.1k_5%_0402 | 贴片电 阻 ,5.1k_5%_0402 | R60 | 0402R | RES | 1

TPS22917DBVR | 至 、 、 1V 5.5V 2A 80m Ω 超低泄漏负 载开关 | U1 | SOT23-6 | TPS22917DBVR | 1

SPX3819M5-L-3.0V | 低压差 SOT23-5 700mVLDO | U2 | SOT23-5 | CAT6219 | 1

XC6209B302MR-G | 低压差线性稳压 (LDO) | U3, U4 | SOT23-5N | XC6209B332-G | 2

STM32L4R9ZIJ6 | | U7 | UFBGA144 | Component_1 | 1
REF3325AIDBZR | TI 参考电压 1.25V | U8 | SOT23-3N | R | 1
AD7682BCPZRL71 | ADI 16 位 250KSPS PulSAR 数模转换器 | U9 | LFCSP-20 | AD7682BCPZRL71 | 1

NX3215SA-32.768KHZ-EXS00A-MU00525 | 32.768KHz 10ppm 无源晶振 | X1 | OSC 3215-2P | XTAL_5032_2P | 1

NX3225GD-8MHZ-SNDK | 无源晶振 8MHzX2 | | OSC 3225-2P | XTAL | 1
