li59533/JunYue_Lora/doc/主板20200119.pdf

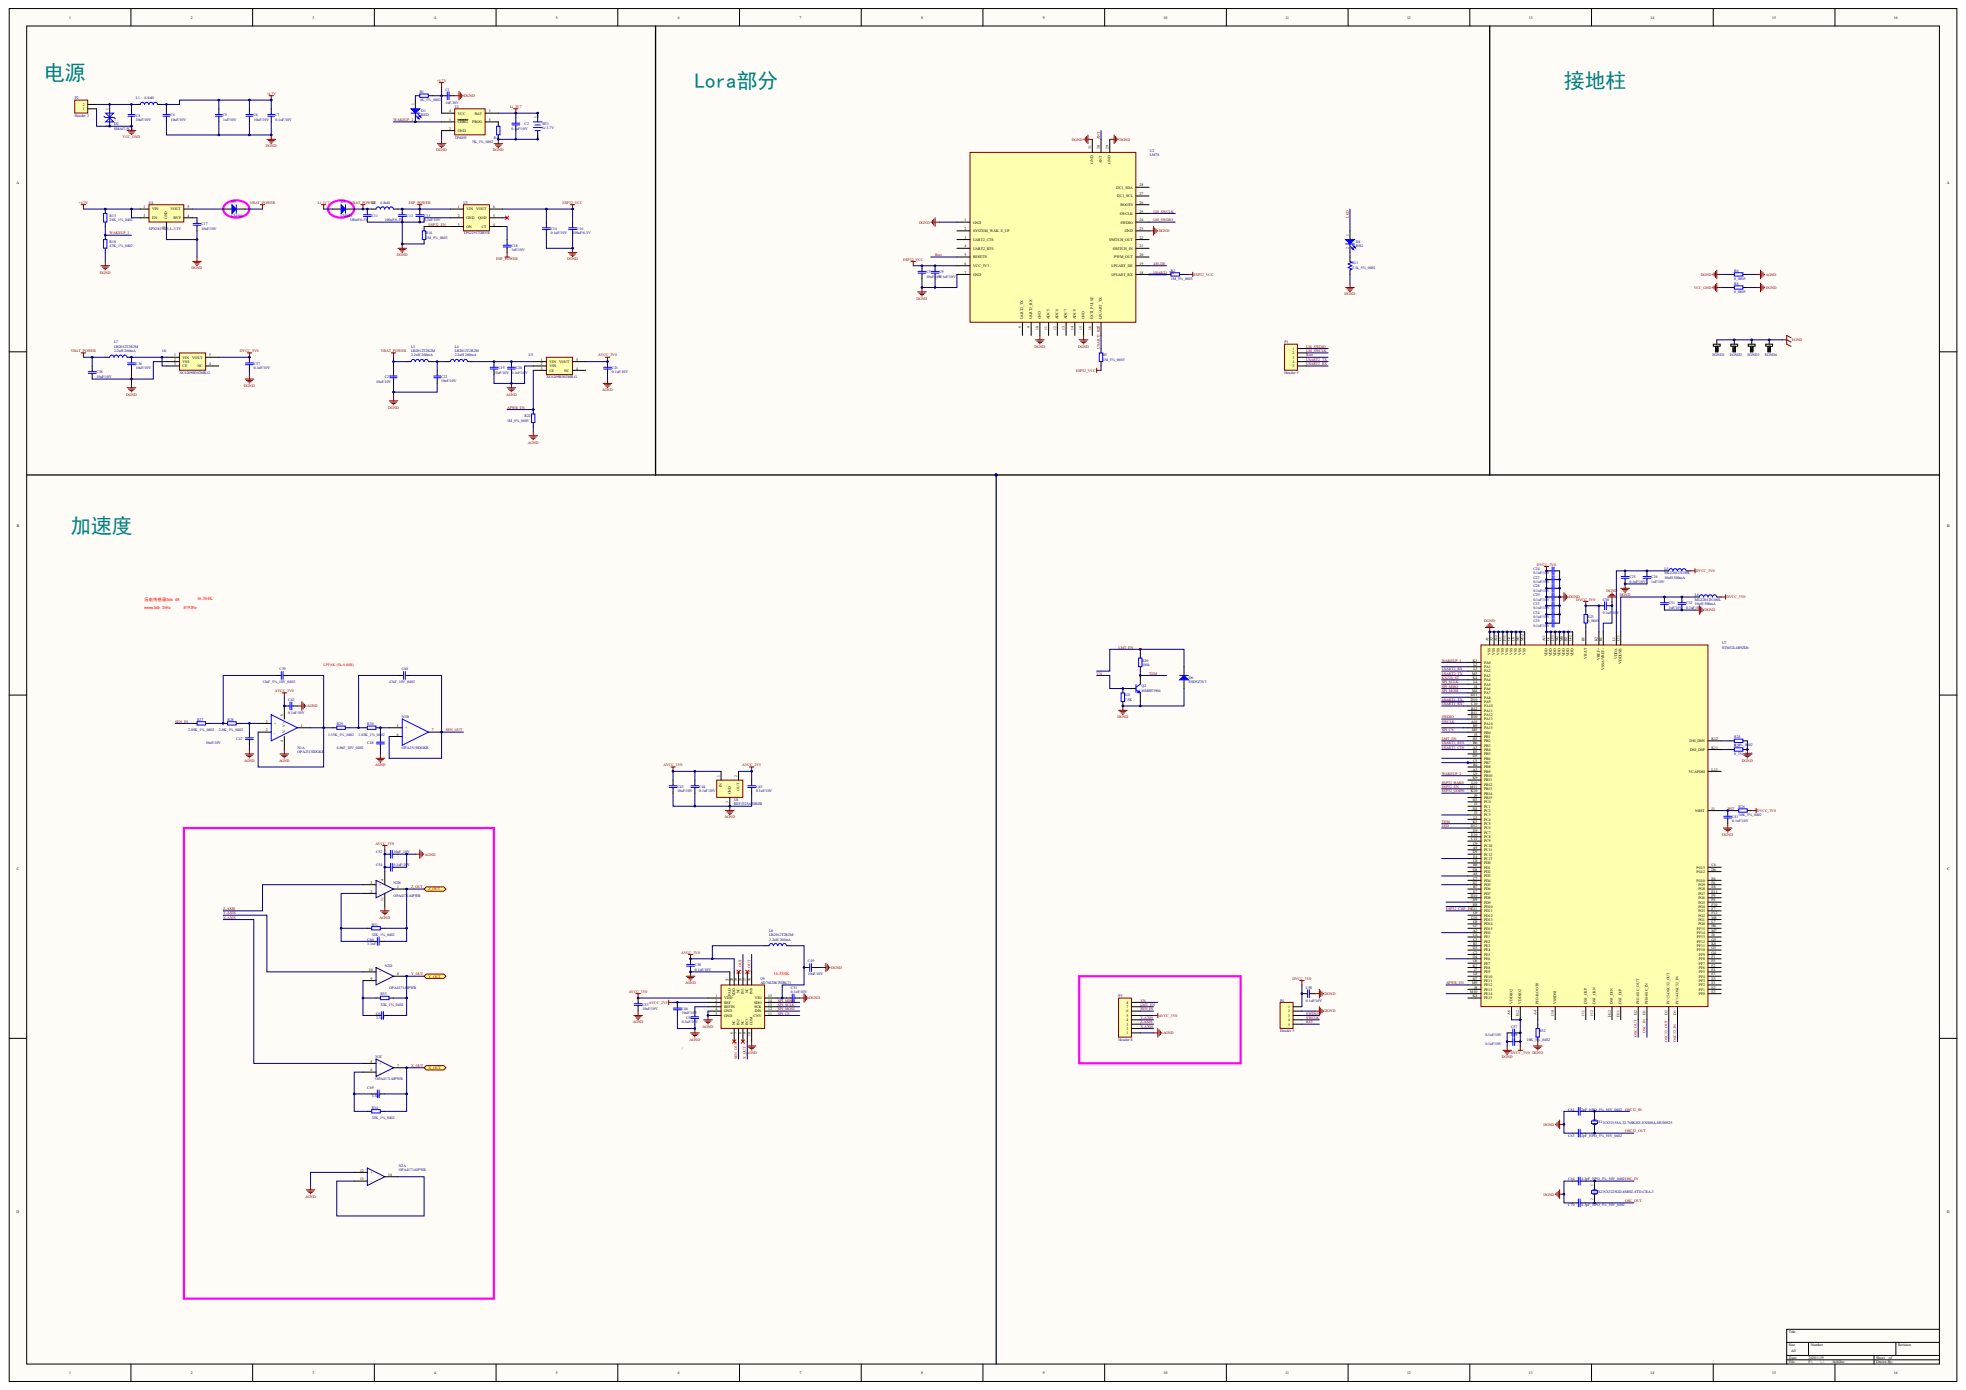
[picture p22: page 1]

COM 10 CNV 11 DIN 12 SCK 13 SDO 14 VIO 15 IN0 16 NC 17 IN1 18 NC 19 VDD 20 PAD 21

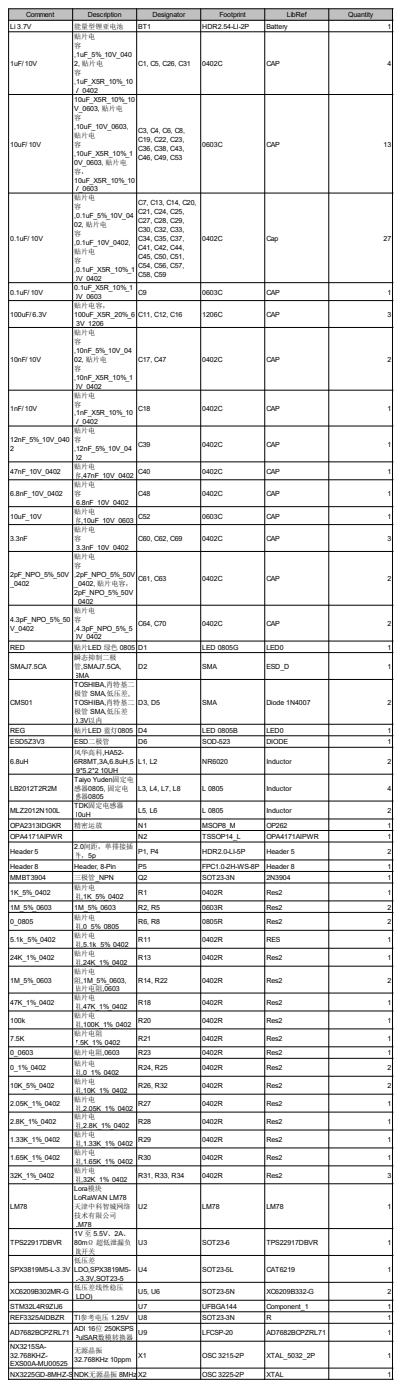
[picture p23: page 2]

Comment | Description | Designator | Footprint | LibRef | Quantity
Li 3.7V | 能量型锂亚电池 | BT1 | HDR2.54-LI-2P | Battery | | 1
1uF/ 10V | 贴片电 容 ,1uF_5%_10V_040 贴片电 2, 容 ,1uF_X5R_10%_10 V_0402 | C1, C5, C26, C31 | 0402C | CAP | | 4

10uF/ 10V | 10uF_X5R_10%_10 V_0603, 贴片电 容 ,10uF_10V_0603, 贴片电 容 ,10uF_X5R_10%_1 0V_0603, 贴片电 容， 10uF_X5R_10%_10 V_0603 | C3, C4, C6, C8, C19, C22, C23, C36, C38, C43, C46, C49, C53 | 0603C | CAP | 13

0.1uF/ 10V | 贴片电 容 ,0.1uF_5%_10V_04 贴片电 02, 容 ,0.1uF_10V_0402, 贴片电 容 ,0.1uF_X5R_10%_1 0V_0402 | C7, C13, C14, C20, C21, C24, C25, C27, C28, C29, C30, C32, C33, C34, C35, C37, C41, C42, C44, C45, C50, C51, C54, C56, C57, C58, C59 | 0402C | Cap | 27

0.1uF/ 10V | 0.1uF_X5R_10%_1 0V_0603 | C9 | 0603C | CAP | | 1

100uF/ 6.3V | 贴片电容， 100uF_X5R_20%_6 .3V_1206 | C11, C12, C16 | 1206C | CAP | | 3

10nF/ 10V | 贴片电 容 ,10nF_5%_10V_04 02, 贴片电 容 ,10nF_X5R_10%_1 0V_0402 | C17, C47 | 0402C | CAP | | 2

1nF/ 10V | 贴片电 容 ,1nF_X5R_10%_10 V_0402 | C18 | 0402C | CAP | | 1

12nF_5%_10V_040 2 | 贴片电 容 ,12nF_5%_10V_04 02 | C39 | 0402C | CAP | | 1

47nF_10V_0402 | 贴片电 ,47nF_10V_0402 容 | C40 | 0402C | CAP | | 1

6.8nF_10V_0402 | 贴片电 容 ,6.8nF_10V_0402 | C48 | 0402C | CAP | | 1

10uF_10V | 贴片电 ,10uF_10V_0603 容 | C52 | 0603C | CAP | | 1

3.3nF | 贴片电 容 ,3.3nF_10V_0402 | C60, C62, C69 | 0402C | CAP | | 3

2pF_NPO_5%_50V _0402 | 贴片电 容 ,2pF_NPO_5%_50V _0402, 贴片电容， 2pF_NPO_5%_50V _0402 | C61, C63 | 0402C | CAP | | 2

4.3pF_NPO_5%_50 V_0402 | 贴片电 容 ,4.3pF_NPO_5%_5 0V_0402 | C64, C70 | 0402C | CAP | | 2

RED | 贴片 LED 绿色 0805 | D1 | LED 0805G | LED0 | | 1
SMAJ7.5CA | 瞬态抑制二极 管 ,SMAJ7.5CA, SMA | D2 | SMA | ESD_D | | 1

CMS01 | TOSHIBA, 肖特基二 极管 SMA, 低压差 , TOSHIBA, 肖特基二 极管 SMA, 低压差 0.3V 以内 | D3, D5 | SMA | Diode 1N4007 | | 2

REG | 贴片 蓝灯 LED 0805 | D4 | LED 0805B | LED0 | | 1
ESD5Z3V3 | ESD 二极管 | D6 | SOD-523 | DIODE | | 1
6.8uH | 风华高科 ,HA52-6R8MT,3A,6.8uH,5 .9*5.2*2 10UH | L1, L2 | NR6020 | Inductor | | 2

LB2012T2R2M | Taiyo Yuden 固定电 感器 0805, 固定电 感器 0805 | L3, L4, L7, L8 | L 0805 | Inductor | | 4

MLZ2012N100L | TDK 10uH 固定电感器 | L5, L6 | L 0805 | Inductor | | 2

OPA2313IDGKR | 精密运放 | N1 | MSOP8_M | OP262 | | 1

OPA4171AIPWR | | N2 | TSSOP14_L | OPA4171AIPWR | | 1
Header 5 | 2.0 间距，单排接插 5p 件， | P1, P4 | HDR2.0-LI-5P | Header 5 | | 2

Header 8 | Header, 8-Pin | P5 | FPC1.0-2H-WS-8P | Header 8 | | 1
MMBT3904 | 三极管 _NPN | Q2 | SOT23-3N | 2N3904 | | 1
1K_5%_0402 | 贴片电 阻 ,1K_5%_0402 | R1 | 0402R | Res2 | | 1

1M_5%_0603 | 1M_5%_0603 | R2, R5 | 0603R | Res2 | | 2
0_0805 | 贴片电 阻 ,0_5%_0805 | R6, R8 | 0805R | Res2 | | 2

5.1k_5%_0402 | 贴片电 ,5.1k_5%_0402 阻 | R11 | 0402R | RES | | 1

24K_1%_0402 | 贴片电 阻 ,24K_1%_0402 | R13 | 0402R | Res2 | | 1

1M_5%_0603 | 贴片电 阻 ,1M_5%_0603, 贴片电阻 ,0603 | R14, R22 | 0402R | Res2 | | 2

47K_1%_0402 | 贴片电 阻 ,47K_1%_0402 | R18 | 0402R | Res2 | | 1

100k | 贴片电 ,100K_1%_0402 阻 | R20 | 0402R | Res2 | | 1

7.5K | 贴片电阻 7.5K_1%_0402 | R21 | 0402R | Res2 | | 1

0_0603 | 贴片电阻 ,0603 | R23 | 0402R | Res2 | | 1
0_1%_0402 | 贴片电 阻 ,0_1%_0402 | R24, R25 | 0402R | Res2 | | 2

10K_5%_0402 | 贴片电 ,10K_1%_0402 阻 | R26, R32 | 0402R | Res2 | | 2

2.05K_1%_0402 | 贴片电 ,2.05K_1%_0402 阻 | R27 | 0402R | Res2 | | 1

2.8K_1%_0402 | 贴片电 阻 ,2.8K_1%_0402 | R28 | 0402R | Res2 | | 1

1.33K_1%_0402 | 贴片电 ,1.33K_1%_0402 阻 | R29 | 0402R | Res2 | | 1

1.65K_1%_0402 | 贴片电 阻 ,1.65K_1%_0402 | R30 | 0402R | Res2 | | 1

32K_1%_0402 | 贴片电 ,32K_1%_0402 阻 | R31, R33, R34 | 0402R | Res2 | | 3

LM78 | Lora 模块 LoRaWAN LM78 天津中科智城网络 技术有限公司 LM78 | U2 | LM78 | LM78 | | 1

TPS22917DBVR | 1V 至 5.5V 2A 、 、 80m Ω 超低泄漏负 载开关 | U3 | SOT23-6 | TPS22917DBVR | | 1

SPX3819M5-L-3.3V | 低压差 LDO,SPX3819M5-L-3.3V,SOT23-5 | U4 | SOT23-5L | CAT6219 | | 1

XC6209B302MR-G | 低压差线性稳压 (LDO) | U5, U6 | SOT23-5N | XC6209B332-G | | 2

STM32L4R9ZIJ6 | | U7 | UFBGA144 | Component_1 | | 1
REF3325AIDBZR | TI 参考电压 1.25V | U8 | SOT23-3N | R | | 1
AD7682BCPZRL71 | ADI 16 位 250KSPS PulSAR 数模转换器 | U9 | LFCSP-20 | AD7682BCPZRL71 | | 1

NX3215SA-32.768KHZ-EXS00A-MU00525 | 无源晶振 32.768KHz 10ppm | X1 | OSC 3215-2P | XTAL_5032_2P | | 1

NX3225GD-8MHZ-SNDK | 无源晶振 8MHzX2 | | OSC 3225-2P | XTAL | | 1
