li59533/JunYue_Lora/doc/PCB20200119/PDF/底板.pdf

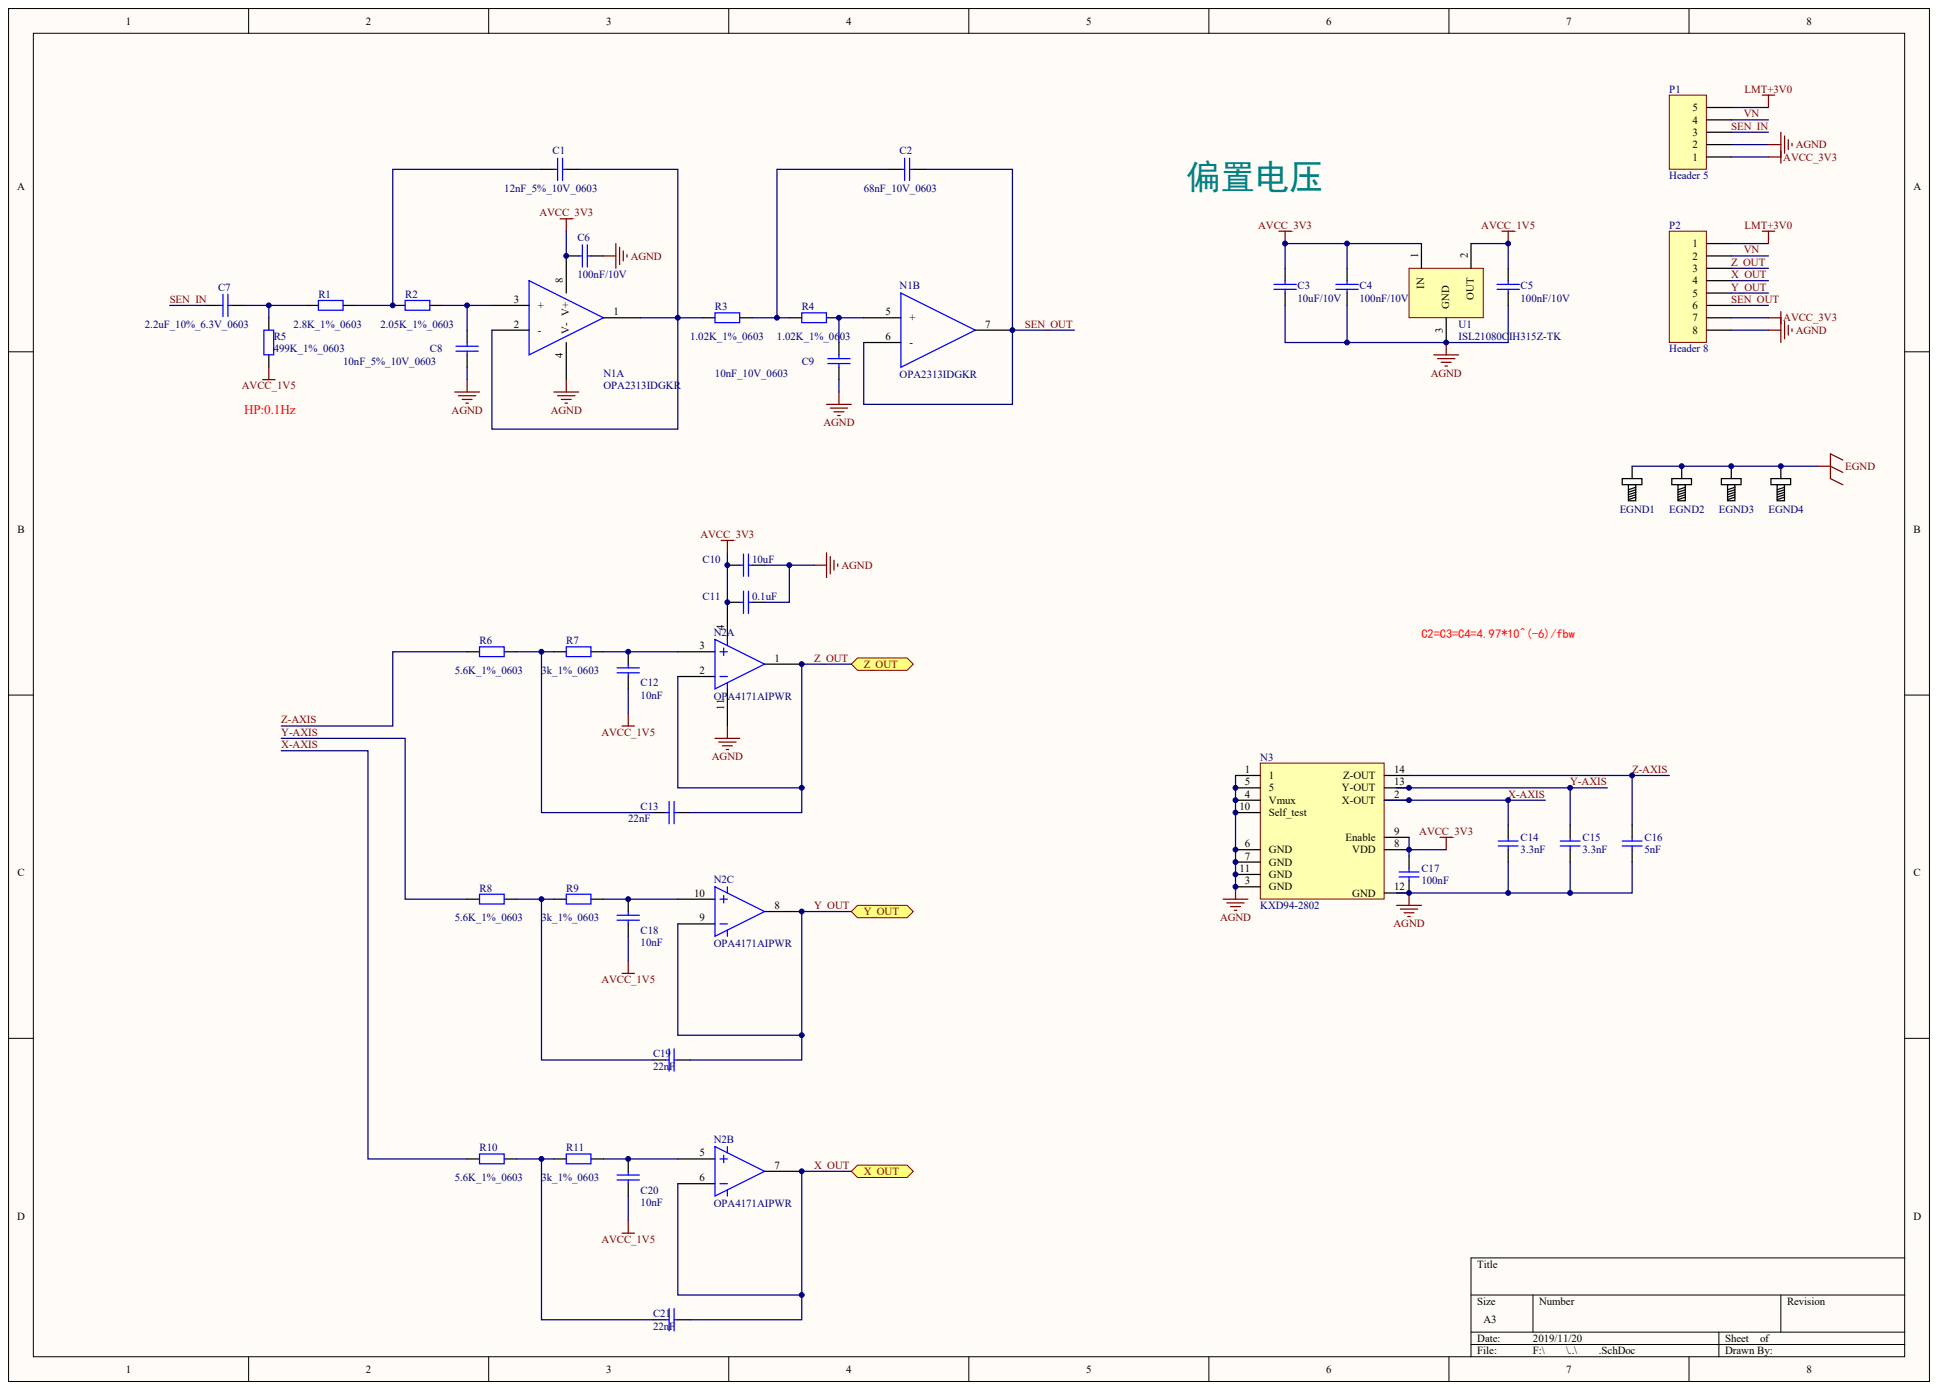
[picture p27: page 1]

Y-AXIS

AVCC_3V3

Comment | Description | Designator | Footprint | LibRef | Quantity
12nF_5%_10V_060 3 | 12nF_5%_10V_060 3 | C1 | 0603C | CAP | 1
68nF_10V_0603 | 68nF_10V_0603 | C2 | 0603C | CAP | 1
10uF/ 10V | 10uF_X5R_10%_10 V_0603 | C3 | 0603c | CAP | 1
100nF/ 10V | 100nF_X5R_10%_1 0V_0603 | C4, C5, C6 | 0603C | CAP | 3
2.2uF_10%_6.3V_0 603 | 2.2uF_10%_6.3V_0 603 | C7 | 0603c | CAP | 1
10nF_5%_10V_060 3 | 10nF_5%_10V_060 3 | C8 | 0603C | CAP | 1
10nF_10V_0603 | 10nF_10V_0603 | C9 | 0603C | CAP | 1
10uF | 10uF_5%_10V_060 3 | C10 | 0603C | CAP | 1
0.1uF | 0.1uF_5%_10V_06 03 | C11 | 0603C | CAP | 1
10nF | 10nF_X5R_10%_10 V_0603 | C12, C18, C20 | 0603C | CAP | 3
22nF | 22nF_X5R_10%_10 V_0603 | C13, C19, C21 | 0603C | CAP | 3
3.3nF | 3.3nF_X5R_10%_1 0V_0603 | C14, C15 | 0603C | Cap | 2
5nF | 5nF_X5R_10%_10 V_0603 | C16 | 0603C | Cap | 1
100nF | Capacitor | C17 | 0603C | Cap | 1
OPA2313IDGKR | 精密运放 | N1 | MSOP8_M | OP262 | 1
OPA4171AIPWR | 贴片集成电路 | N2 | TSSOP14_L | LM324 | 1
KXD94-2802 | | N3 | LFDFN-14 | KXR94 | 1
Header 5 | Header, 5-Pin | P1 | 5p | Header 5 | 1
Header 8 | Header, 8-Pin | P2 | FPC1.0-2H-WS-8P | Header 8 | 1
2.8K_1%_0603 | | R1 | 0603R | Res2 | 1
2.05K_1%_0603 | 2.05K_1%_0603 | R2 | 0603R | Res2 | 1
1.02K_1%_0603 | | R3, R4 | 0603R | Res2 | 2
499K_1%_0603 | 499K_1%_0603 | R5 | 0603R | Res | 1
5.6K_1%_0603 | 5.6K_1%_0603 | R6, R8, R10 | 0603R | Res2 | 3
3k_1%_0603 | 3k_1%_0603 | R7, R9, R11 | 0603R | Res2 | 3
ISL21080CIH315Z-T | 参考电压 1.5V | U1 | SOT23-3N | R | 1
