li59533/JunYue_Lora/doc/LORA防爆/04 元器件焊接装配图/LQC7.820.2800-20.pdf

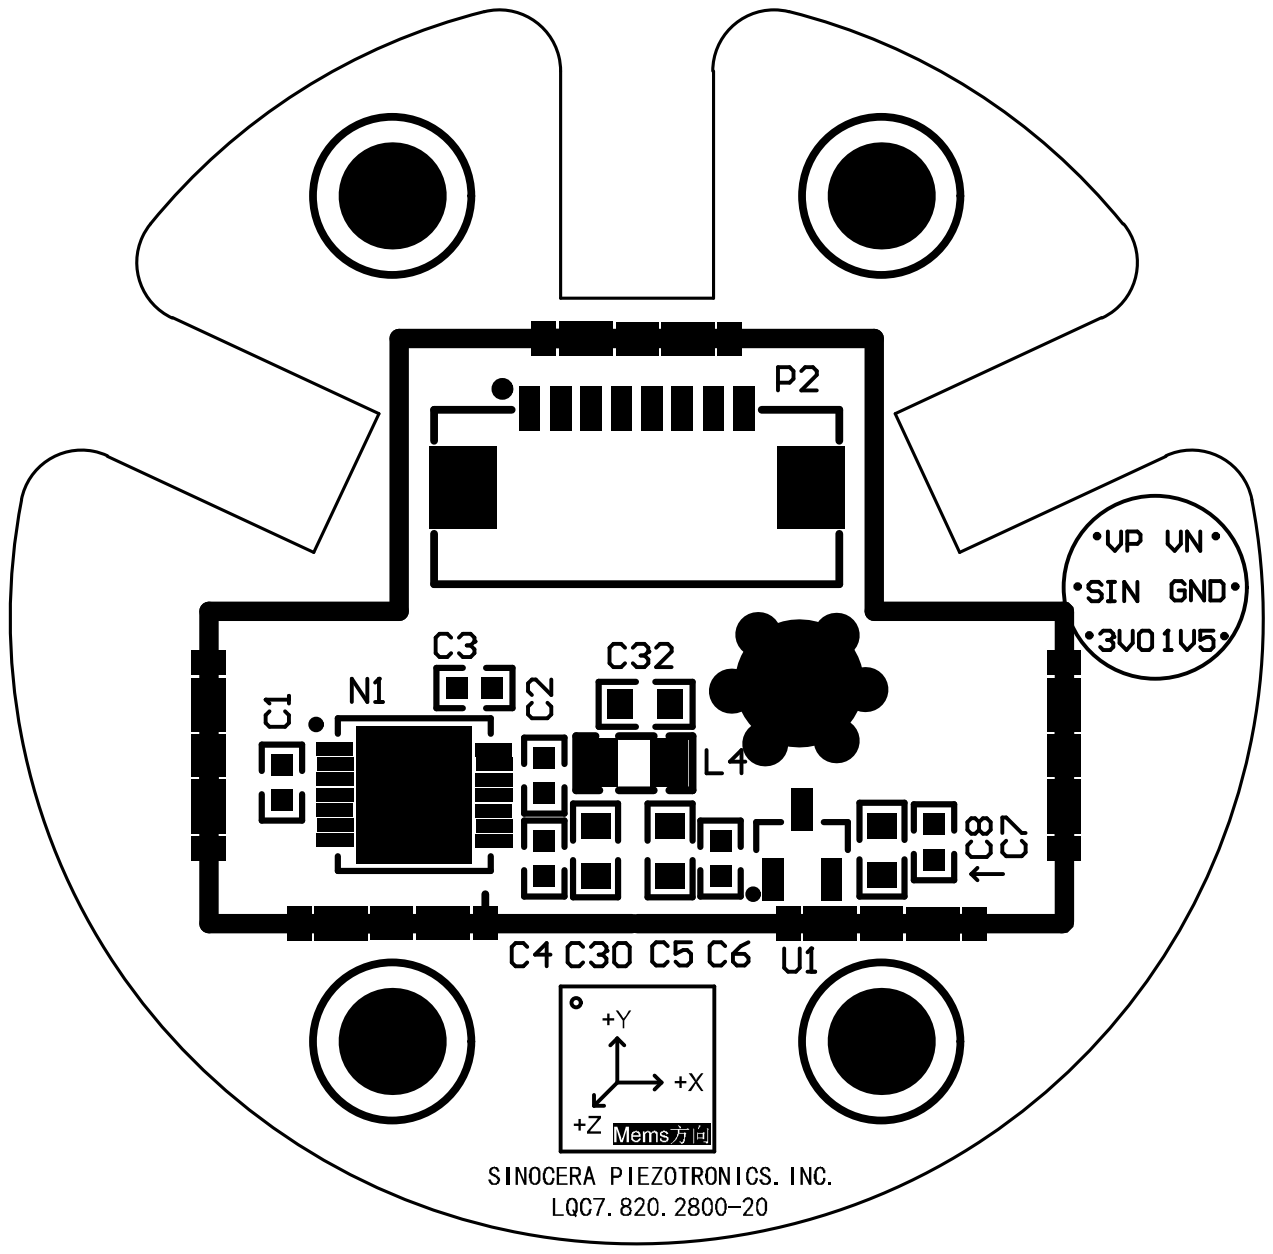
[picture p28: page 1]

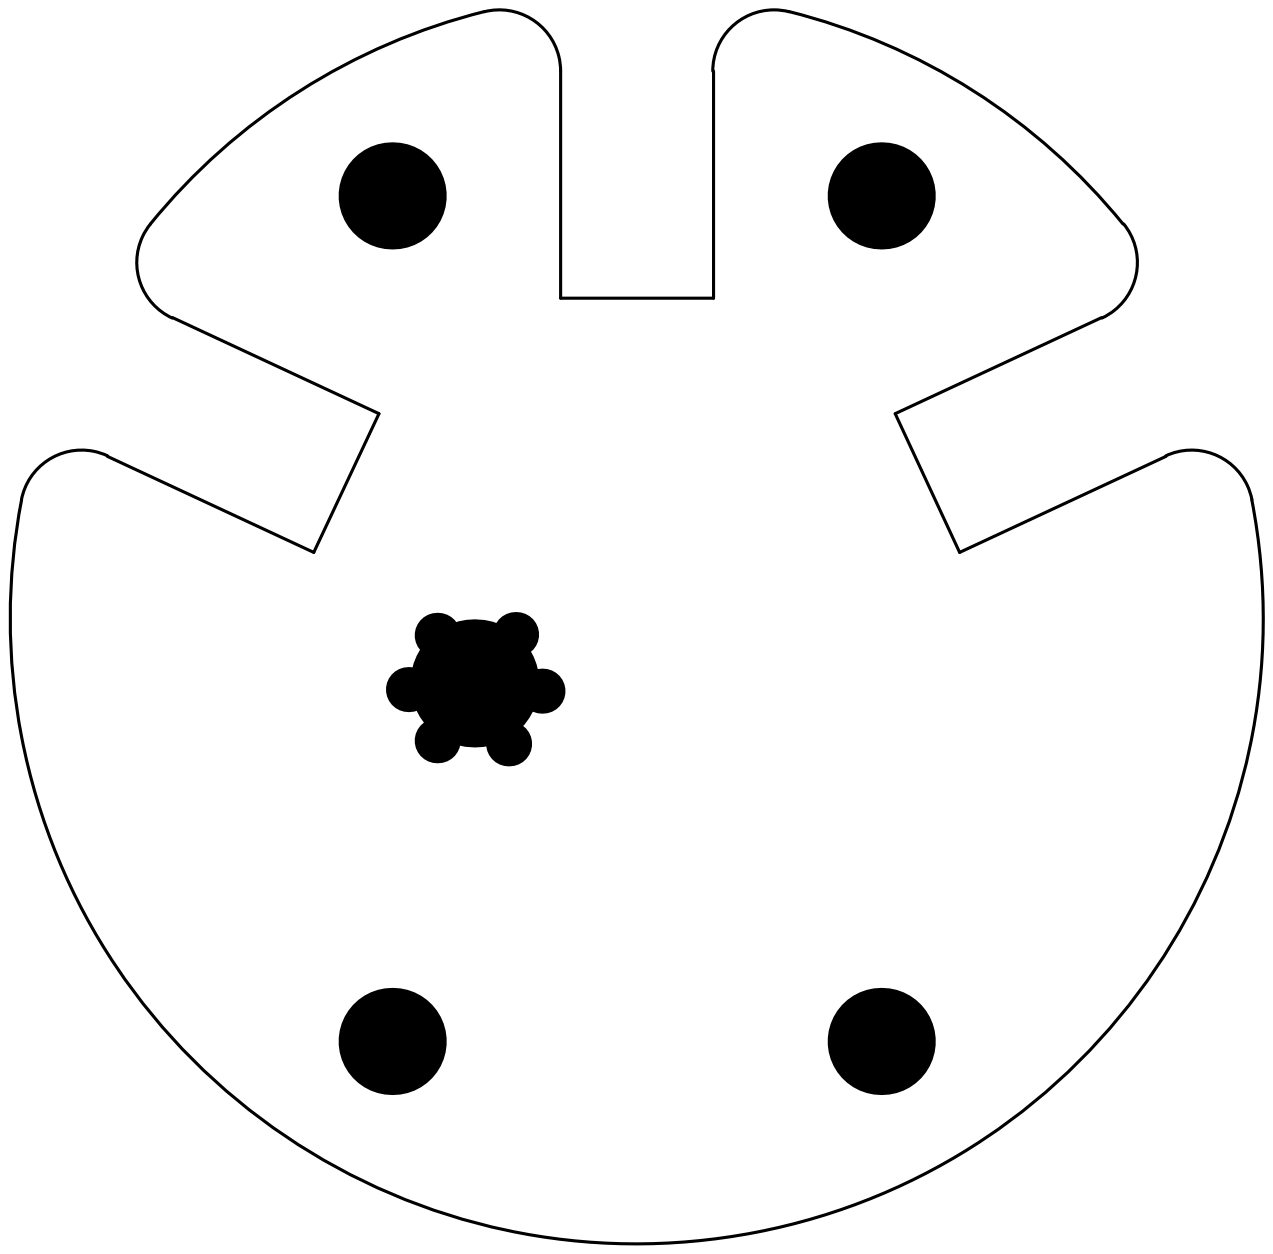
[picture p29: page 2]
