li59533/JunYue_Lora/doc/LORA防爆/04 元器件焊接装配图/LQC7.820.2901-20.pdf

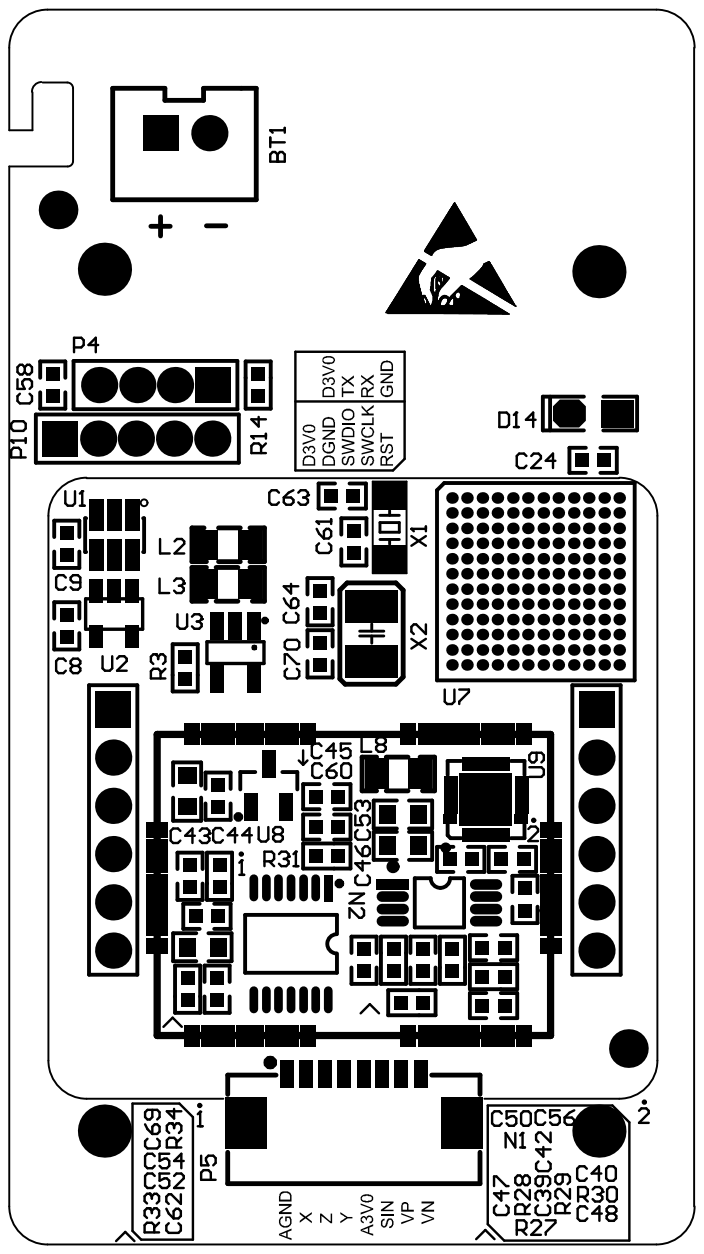
[picture p30: page 1]

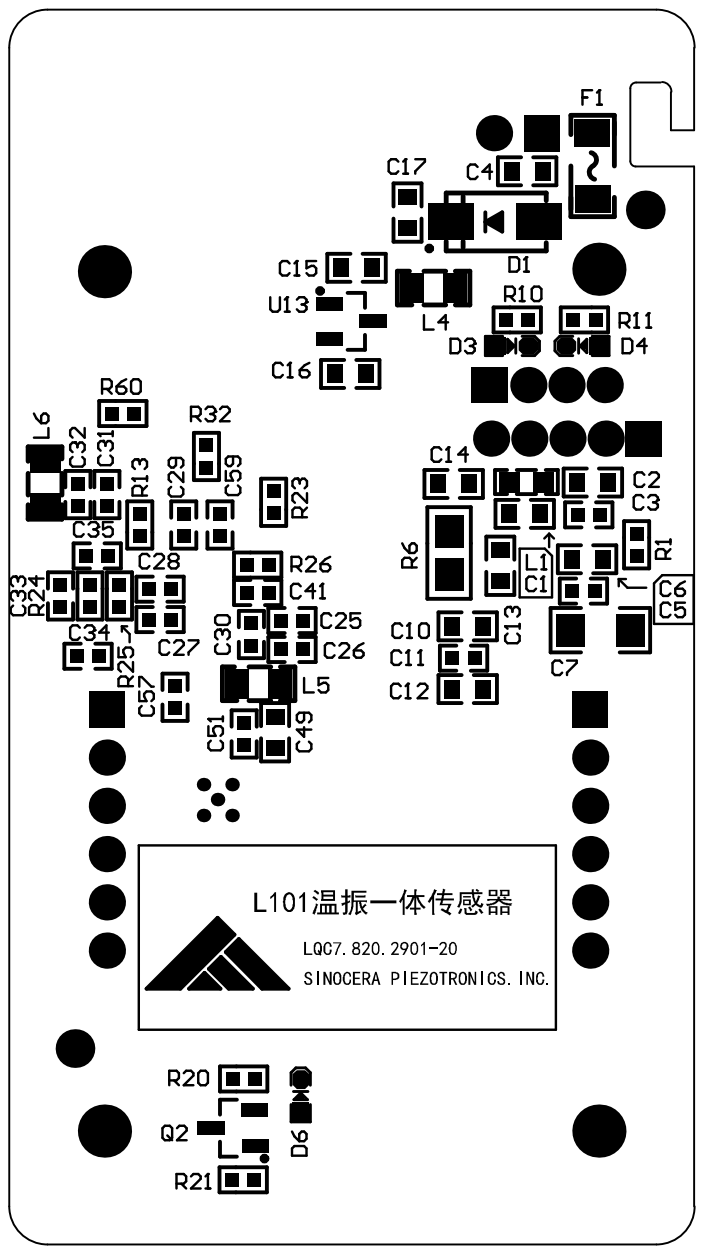
[picture p31: page 2]
