li59533/JunYue_Lora/doc/LORA防爆/04 元器件焊接装配图/LQC7.820.2901-6.pdf

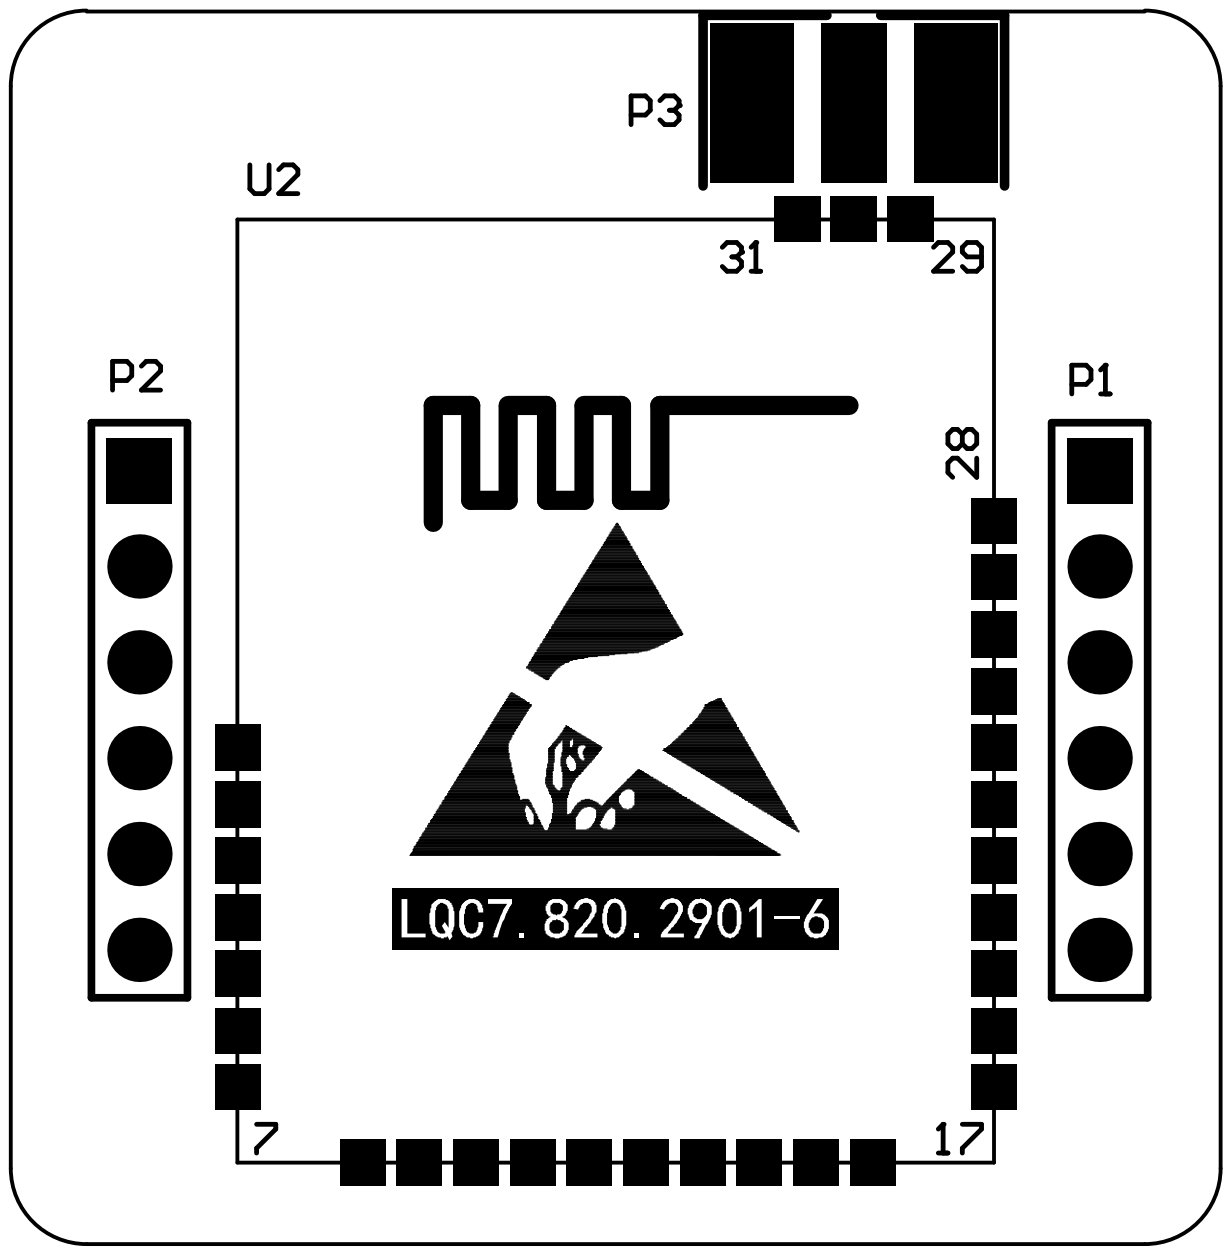
[picture p32: page 1]

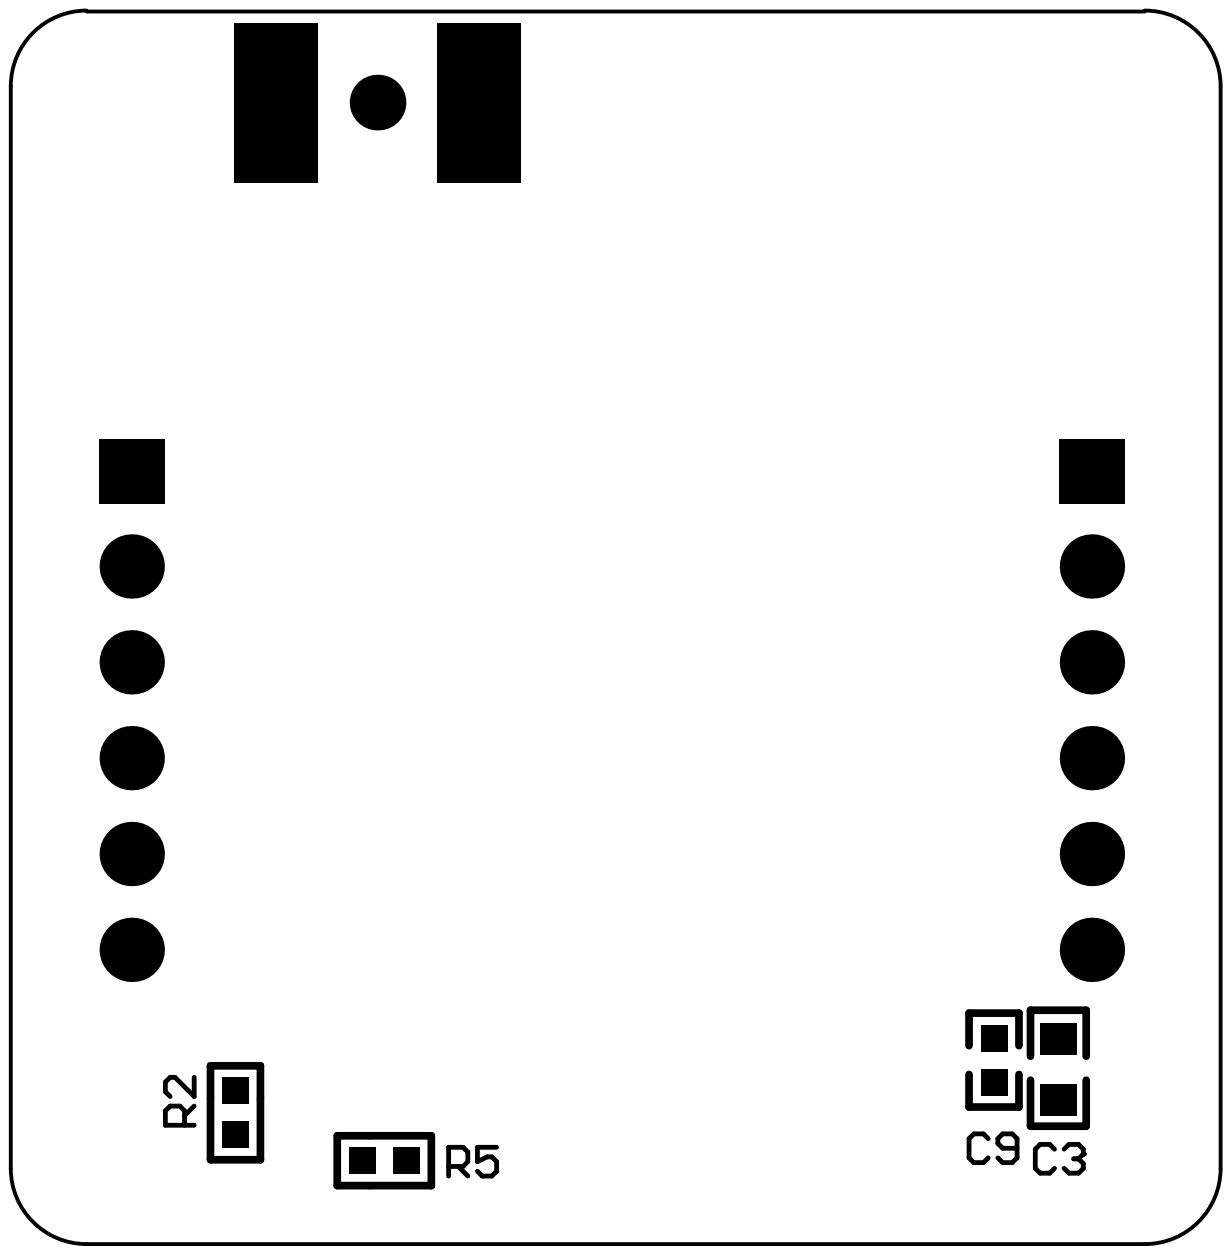
[picture p33: page 2]
