li59533/JunYue_Lora/doc/智城网络_网络操作_20200804.pdf

# 智城网络操作

# 推荐shell软件

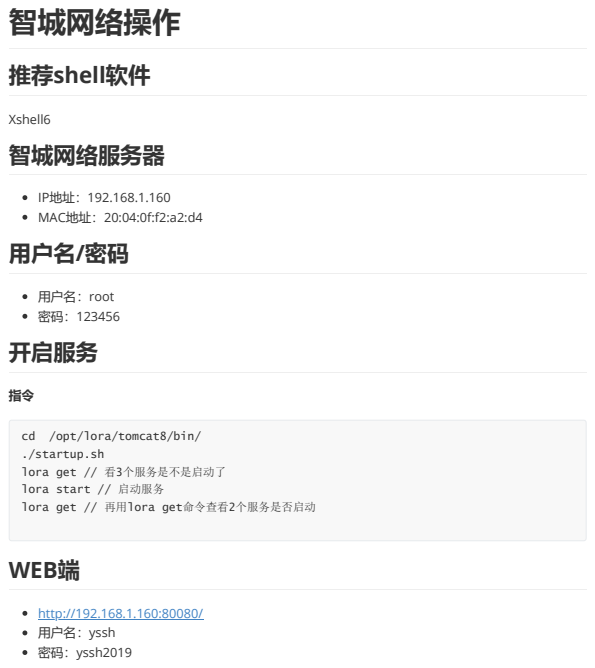
[picture p34: page 1]
Xshell6 智城网络服务器; IP地址：192.168.1.160 MAC地址：20:04:0f:f2:a2:d4 用户名/密码; 用户名：root 密码：123456 开启服务; http://192.168.1.160:80080/ 用户名：yssh 密码：yssh2019; /opt/lora/tomcat8/bin/

./startup.sh
lora get // 看3个服务是不是启动了
lora start // 启动服务
lora get // 再用lora get命令查看2个服务是否启动
WEB端
