li59533/JunYue_Lora/doc/主板测试板_20200310.pdf

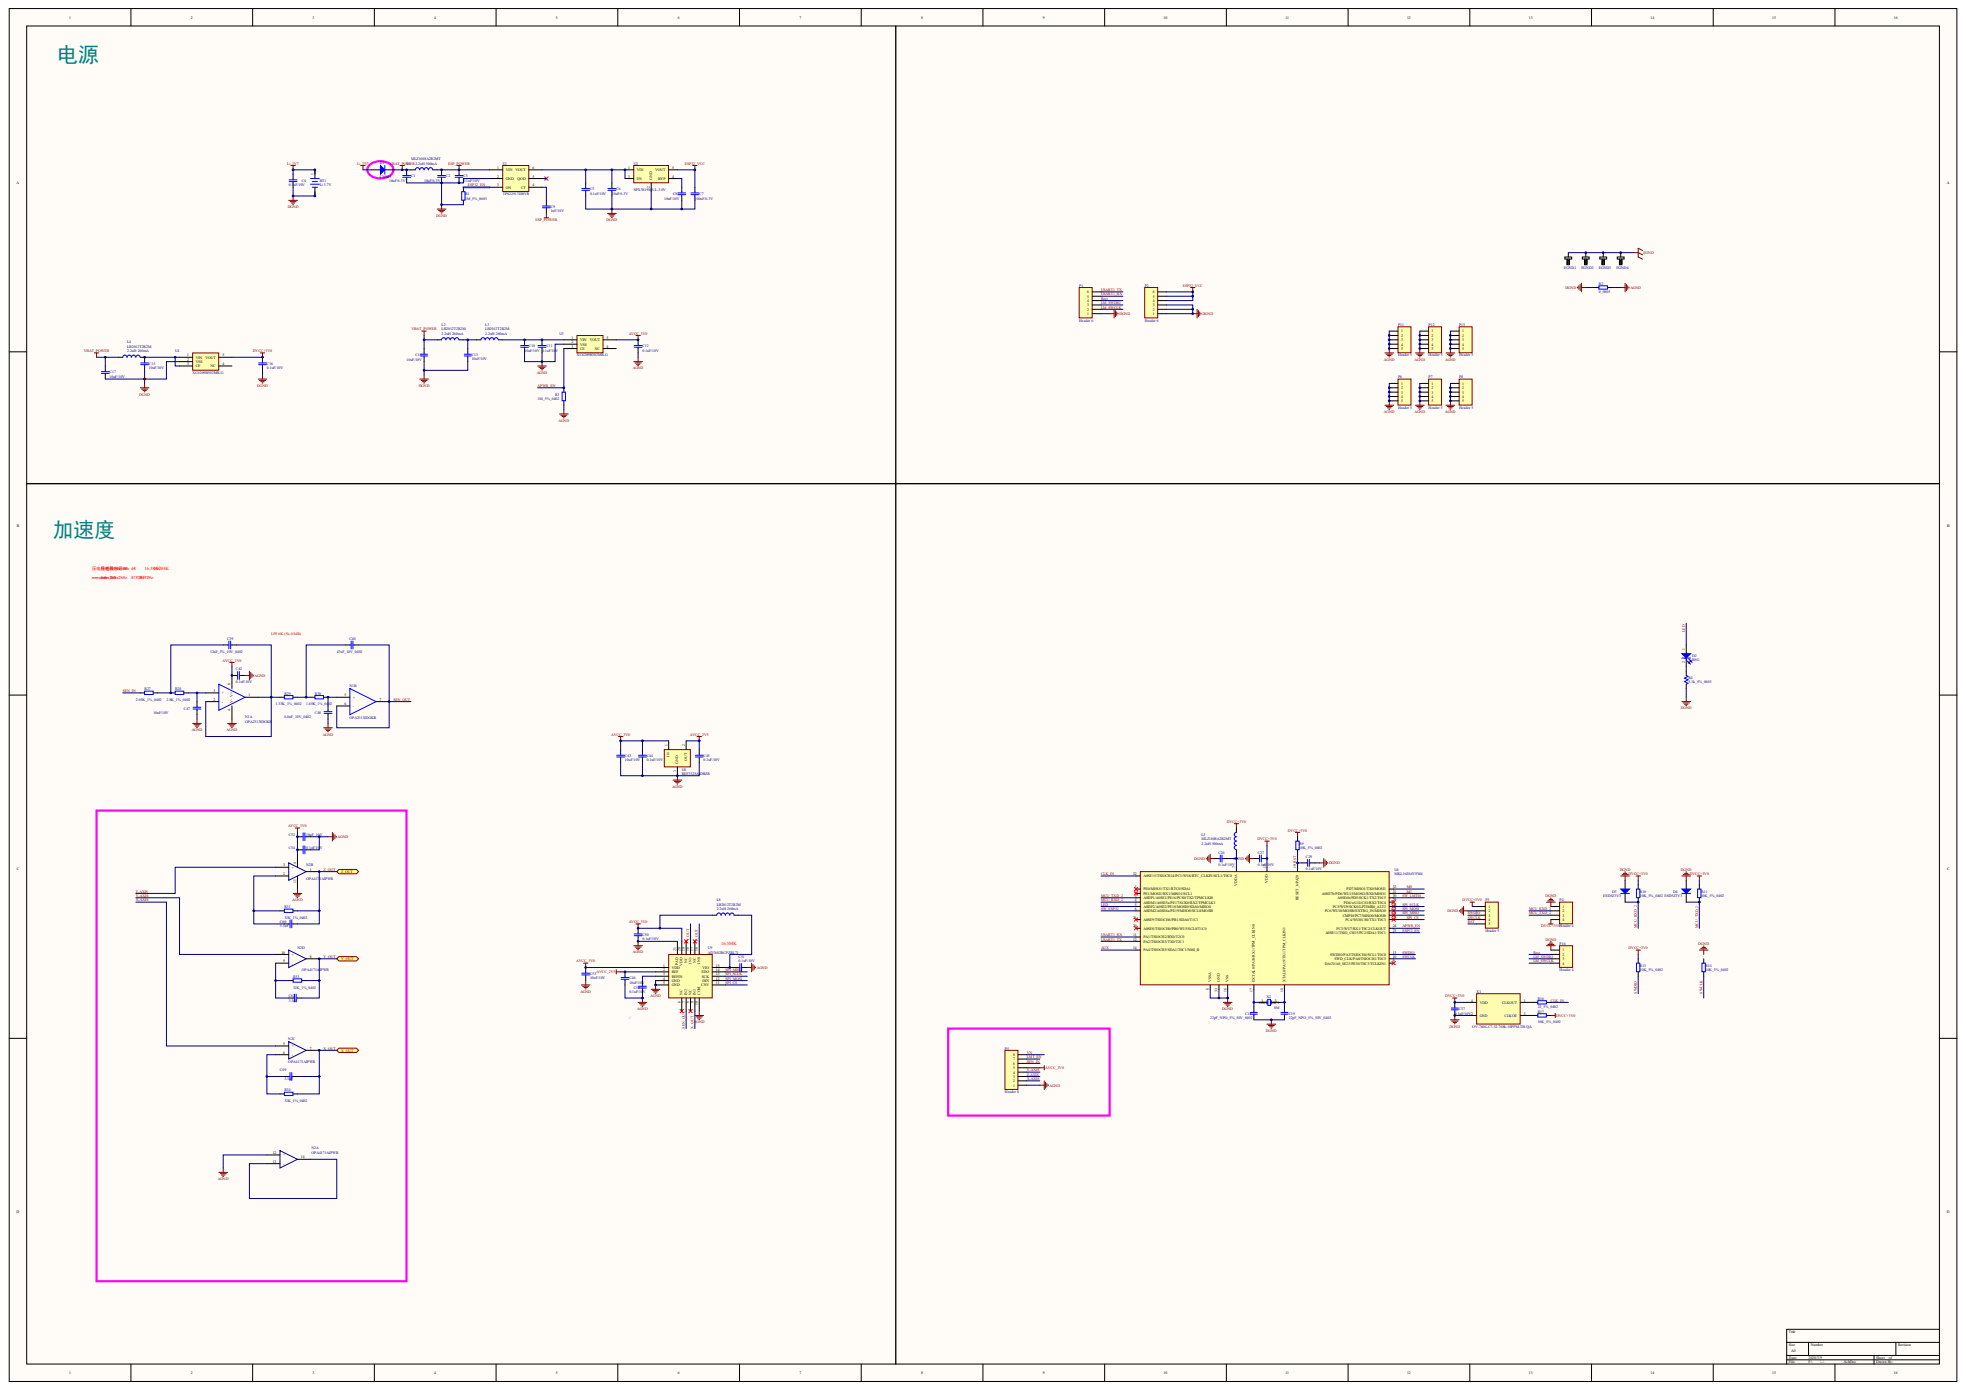
[picture p35: page 1]

U8REF 3325 | A

IN0 16 NC 17 IN1 18 NC 19 VDD 20 PAD 21
