li59533/JunYue_Lora/doc/LORA防爆/01 结构图/上盖.pdf

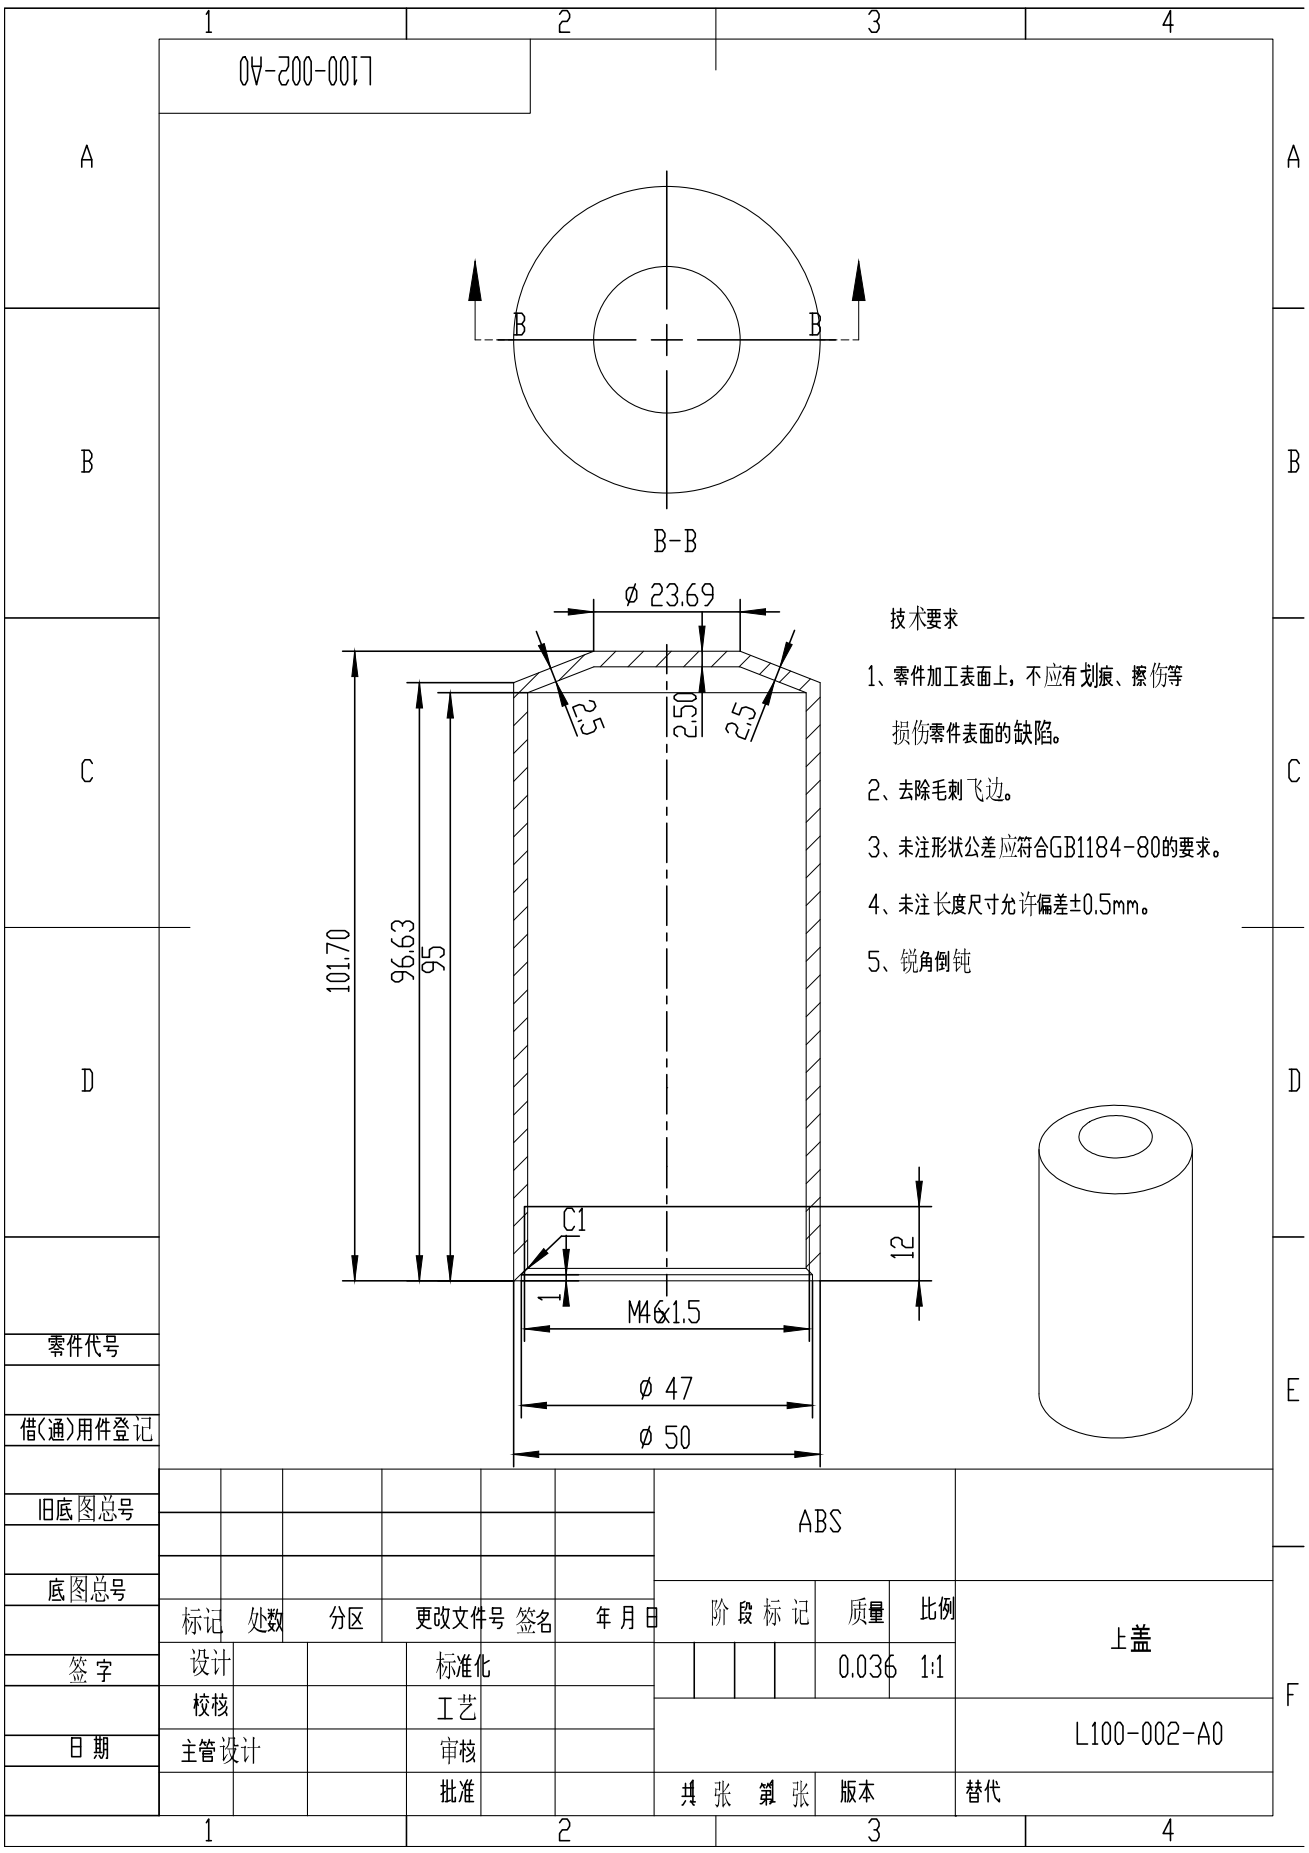
[picture p36: page 1]
