li59533/JunYue_Lora/doc/LORA防爆/01 结构图/基座.pdf

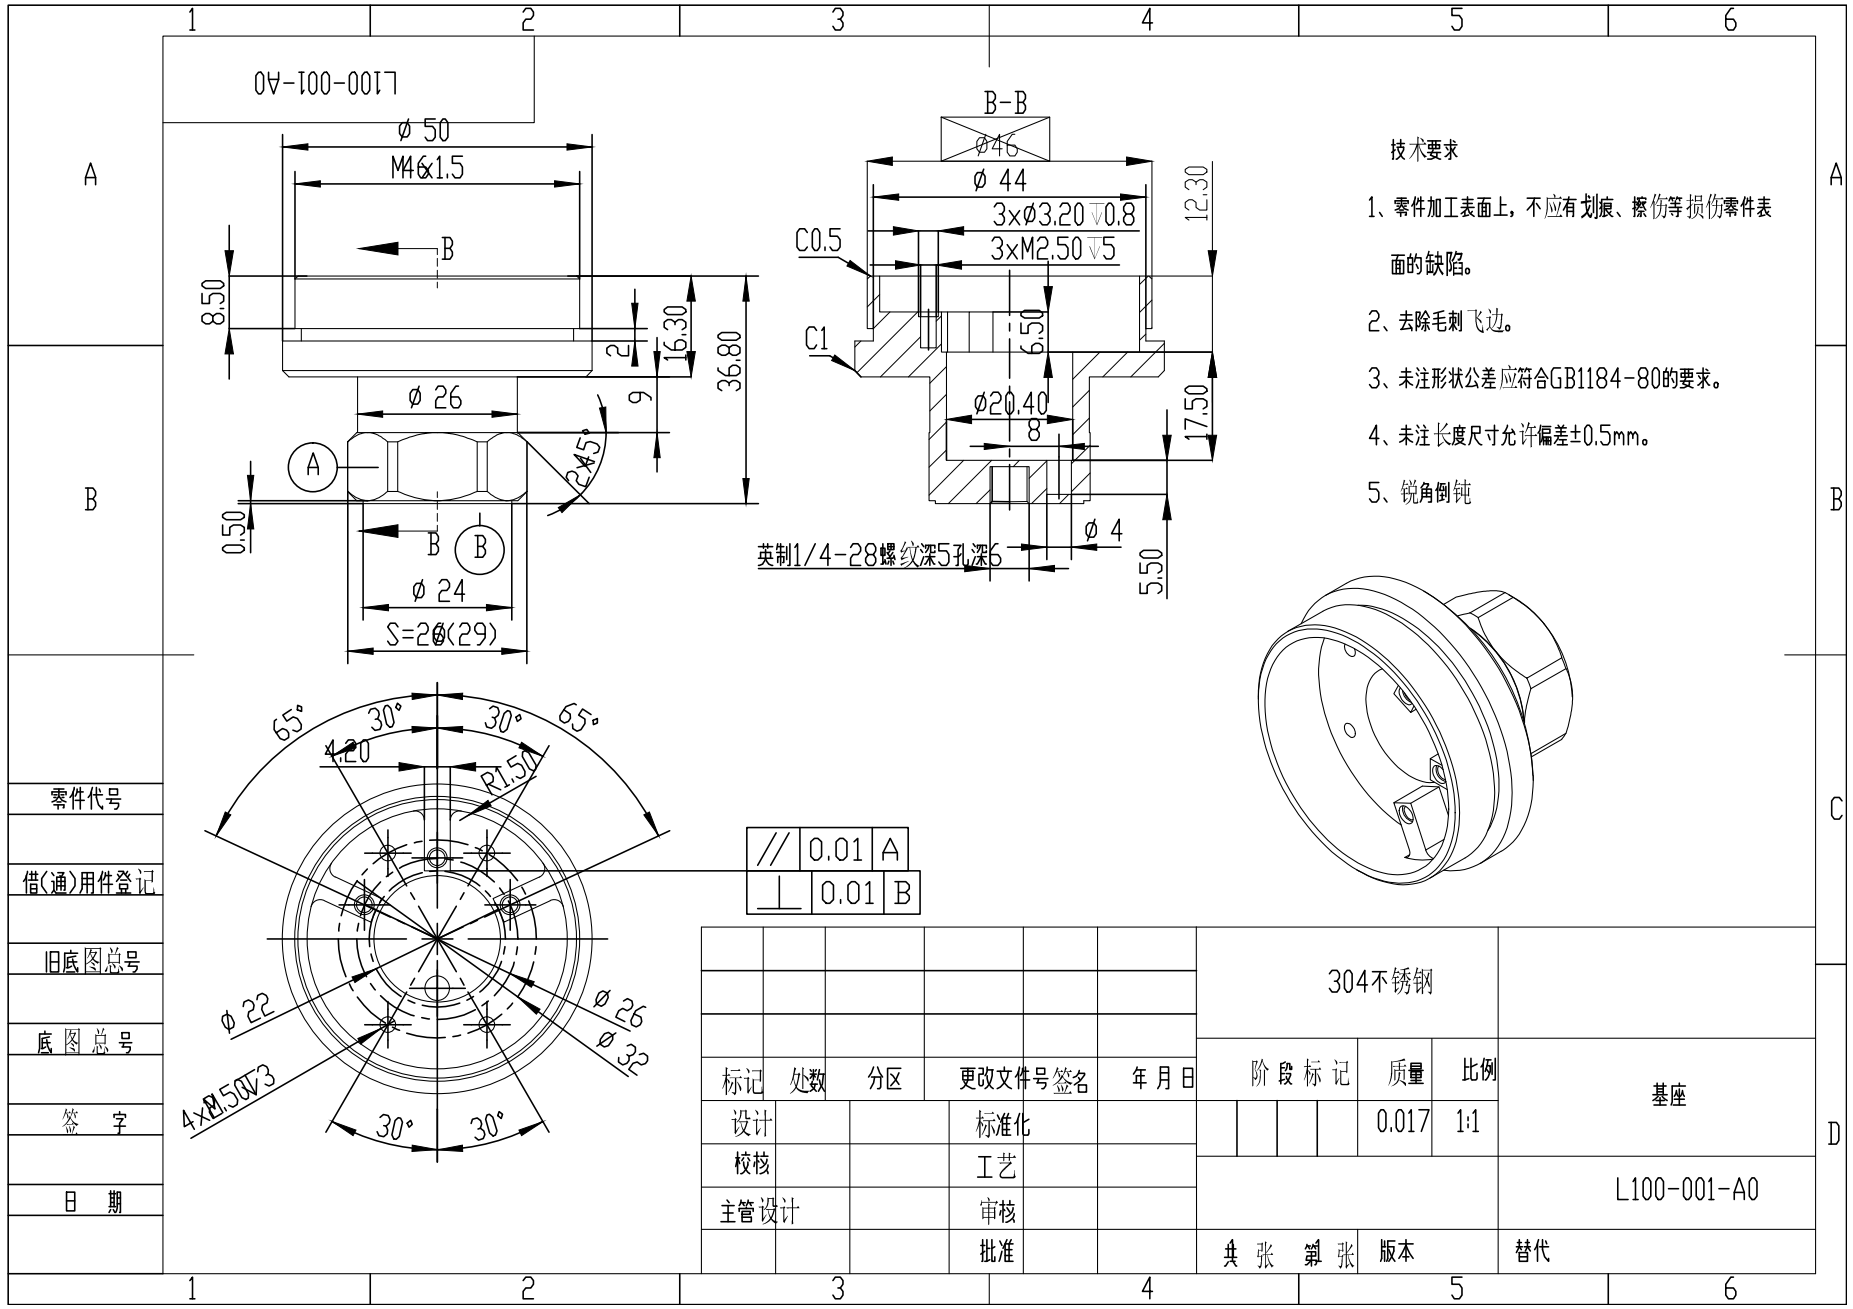
[picture p38: page 1]
