li59533/JunYue_Lora/doc/LORA防爆/01 结构图/电池盒（外扣）.PDF

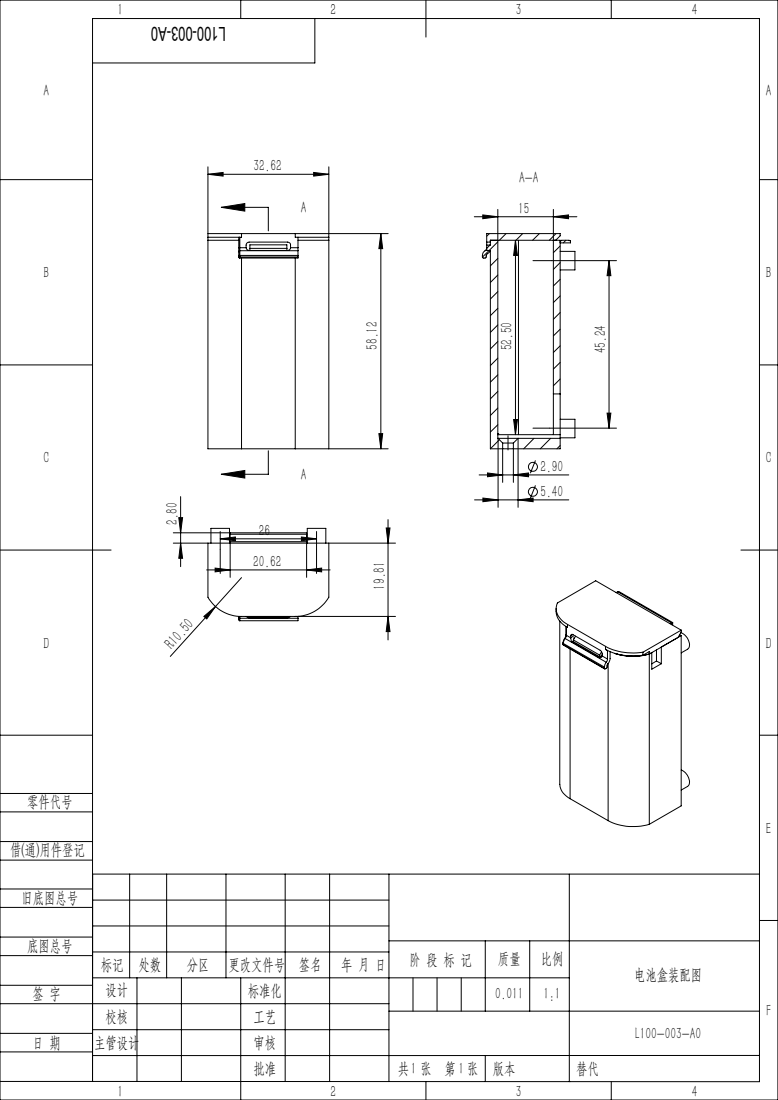
[picture p41: page 1]

阶 段 标 记 | 质量 | 比例 | 电池盒装配图

标记 | 处数 | 分区 | 更改文件号 | 签名 | 年 月 日
设计 | | | 标准化 | | | | | | 0.011 | 1:1
校核 | | | 工艺
主管设计 | | | 审核
