li59533/JunYue_Lora/doc/LORA防爆/02 原理图/LQC7.820.2800-20.pdf

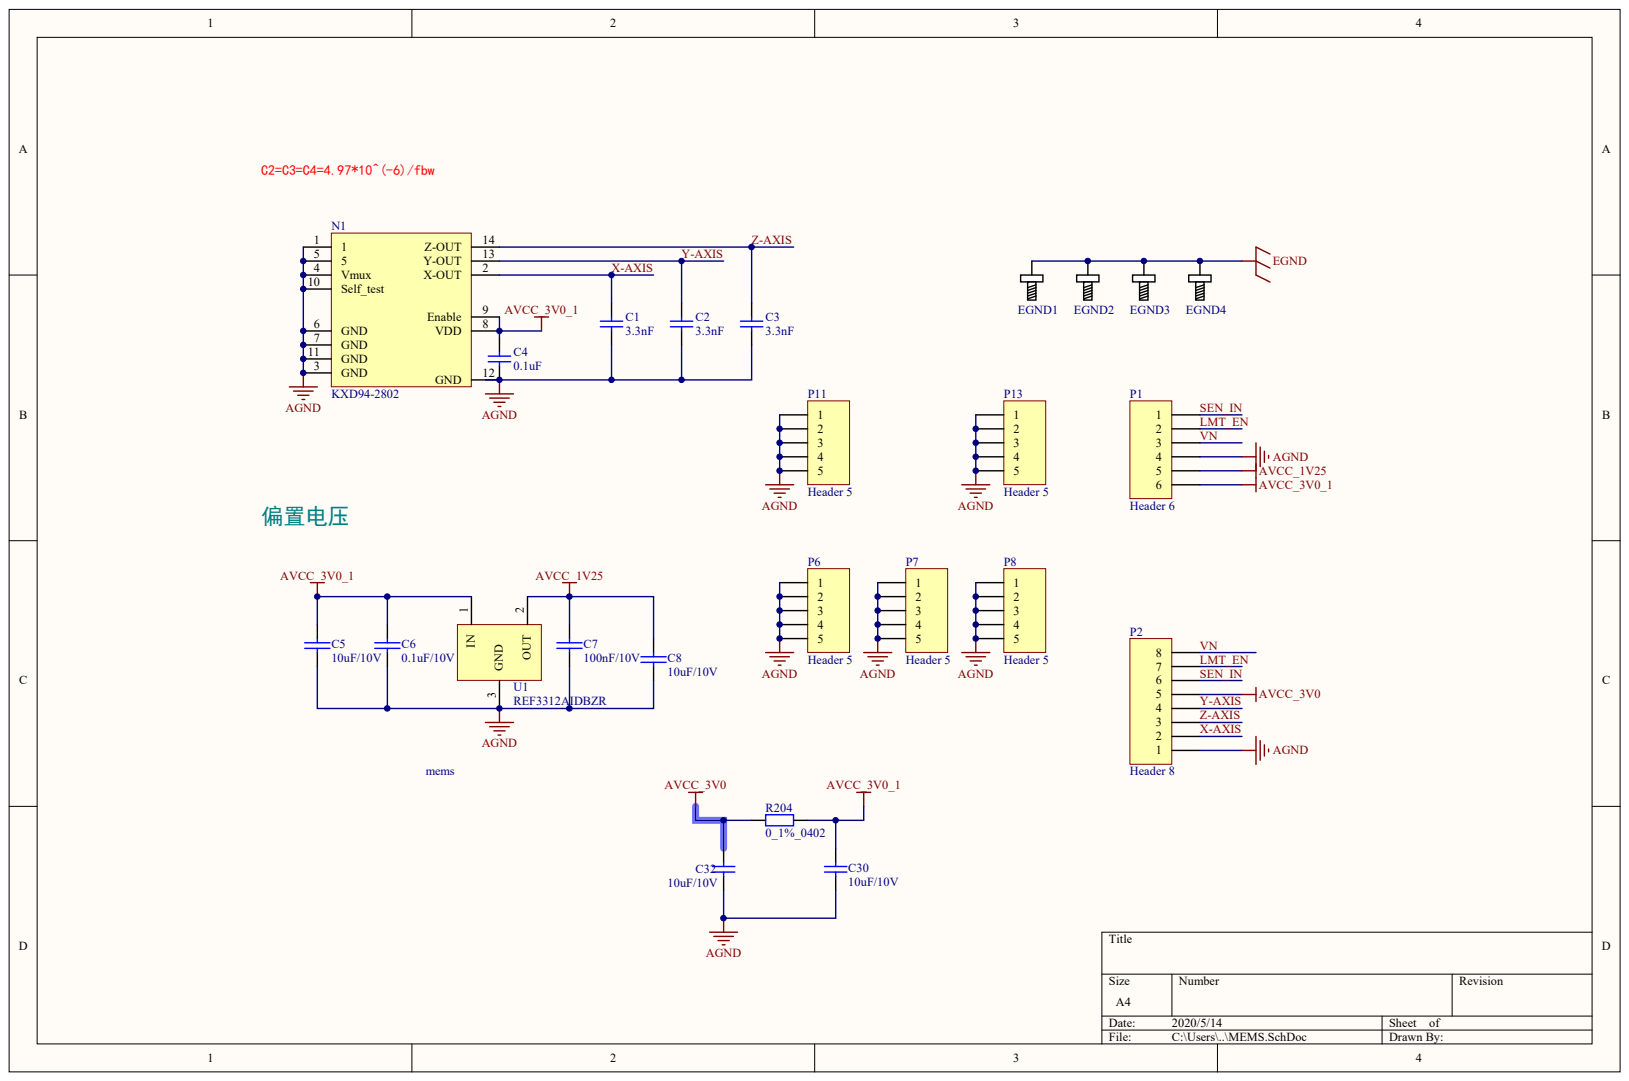
[picture p42: page 1]
