li59533/JunYue_Lora/doc/LORA防爆/02 原理图/LQC7.820.2901-6.pdf

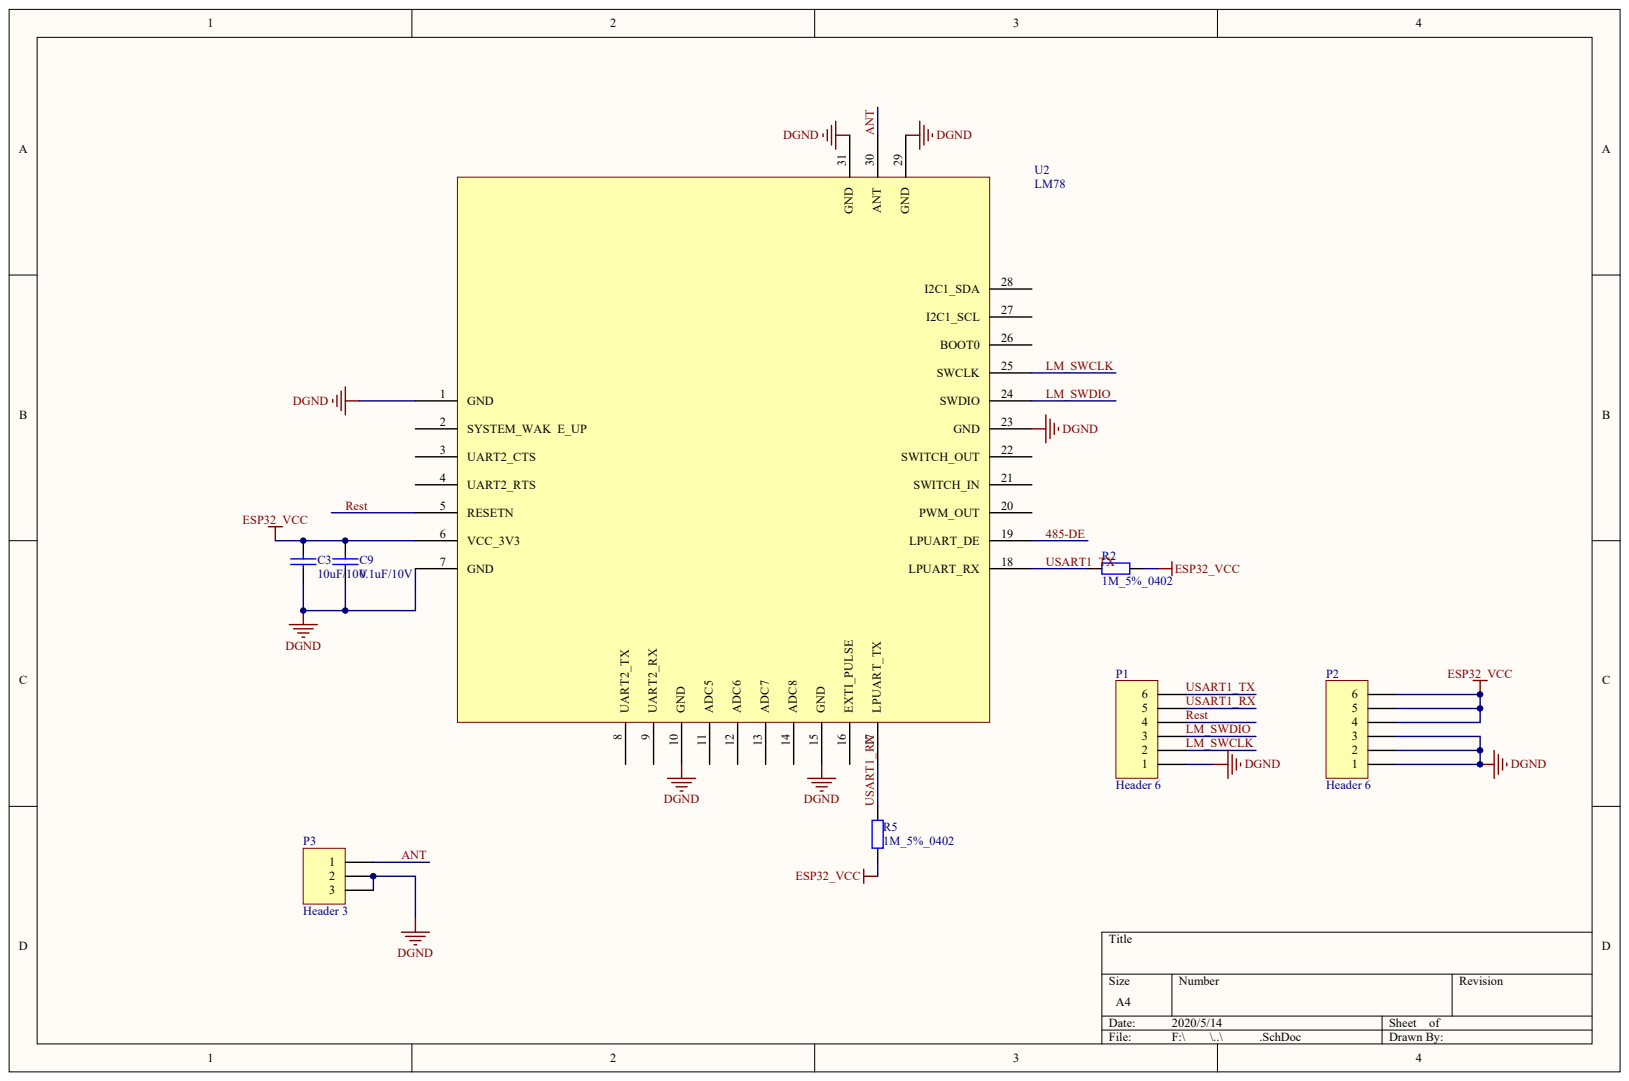
[picture p43: page 1]
