li59533/JunYue_Lora/doc/LORA防爆/03 印制板/LQC7.820.2800-20.pdf

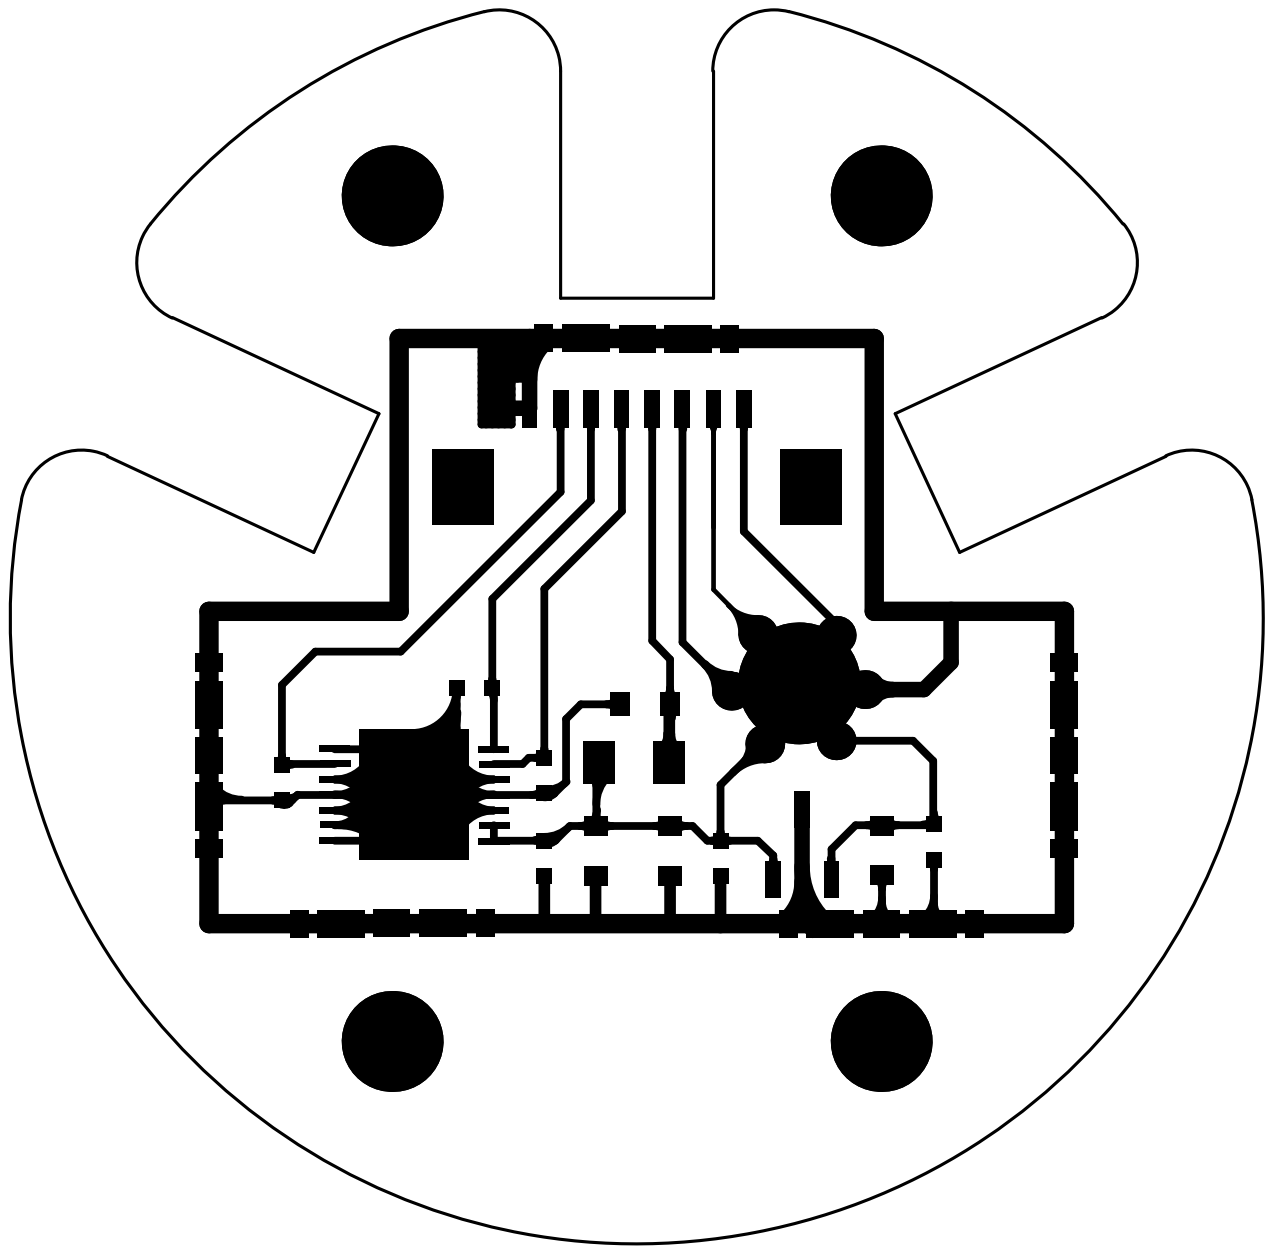
[picture p44: page 1]

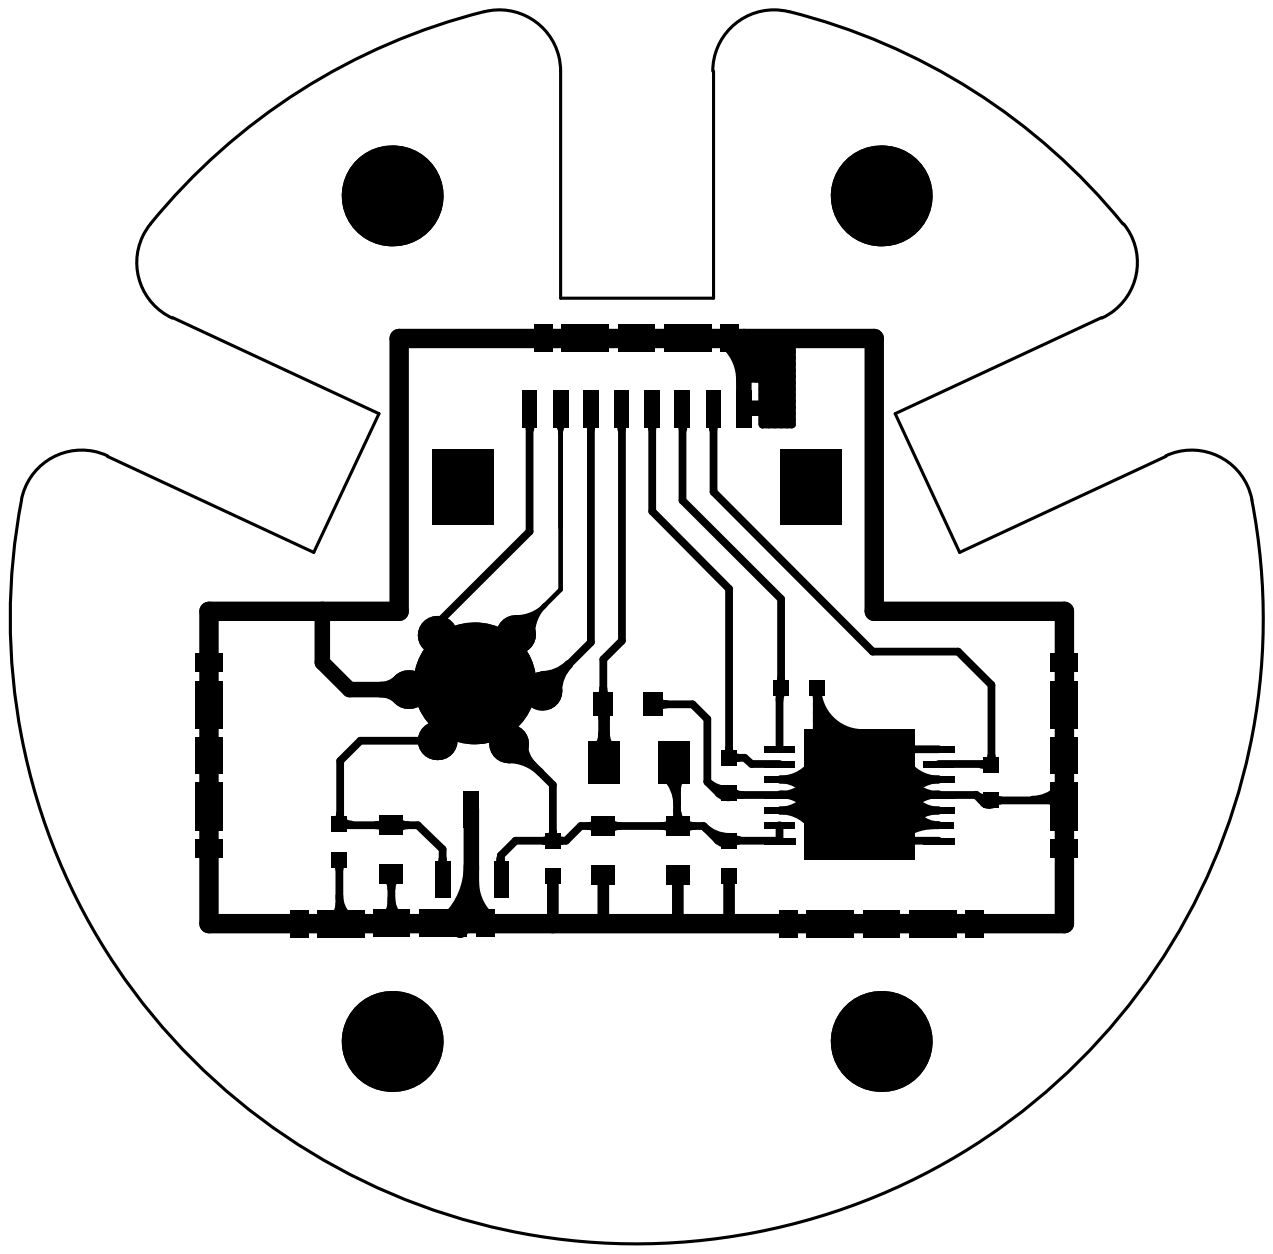
[picture p45: page 2]
