li59533/JunYue_Lora/doc/LORA防爆/03 印制板/LQC7.820.2901-20.pdf

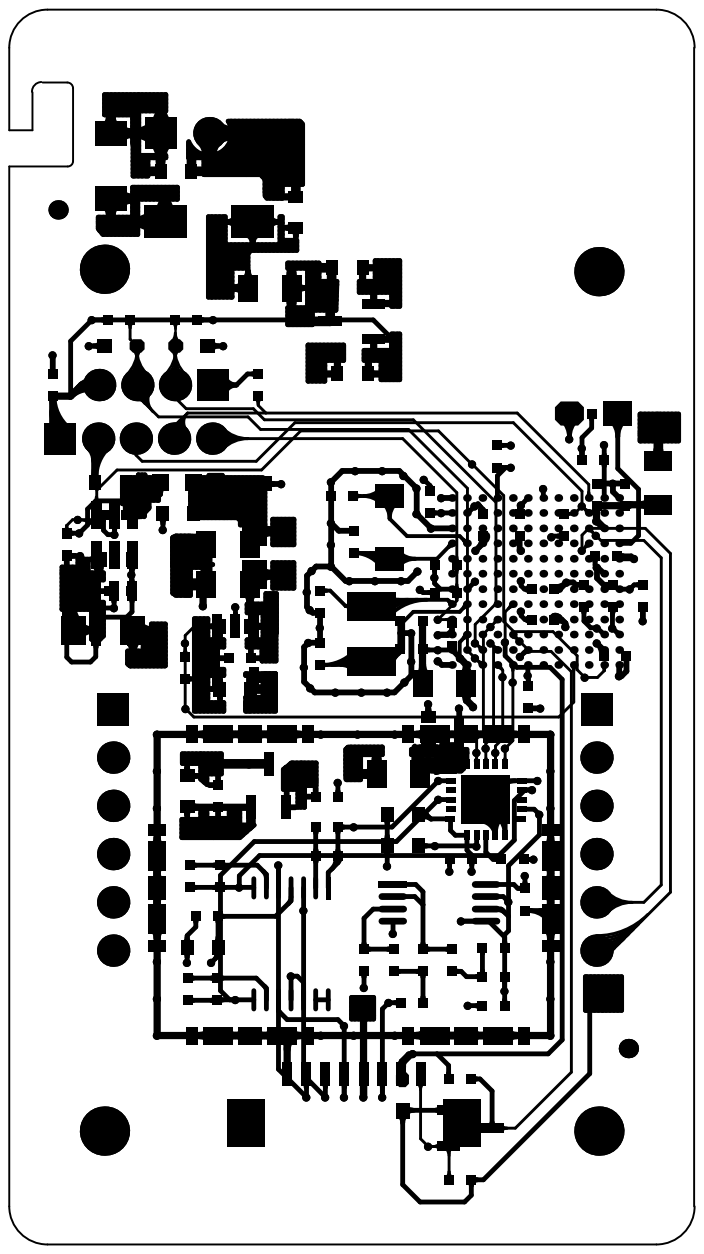
[picture p46: page 1]

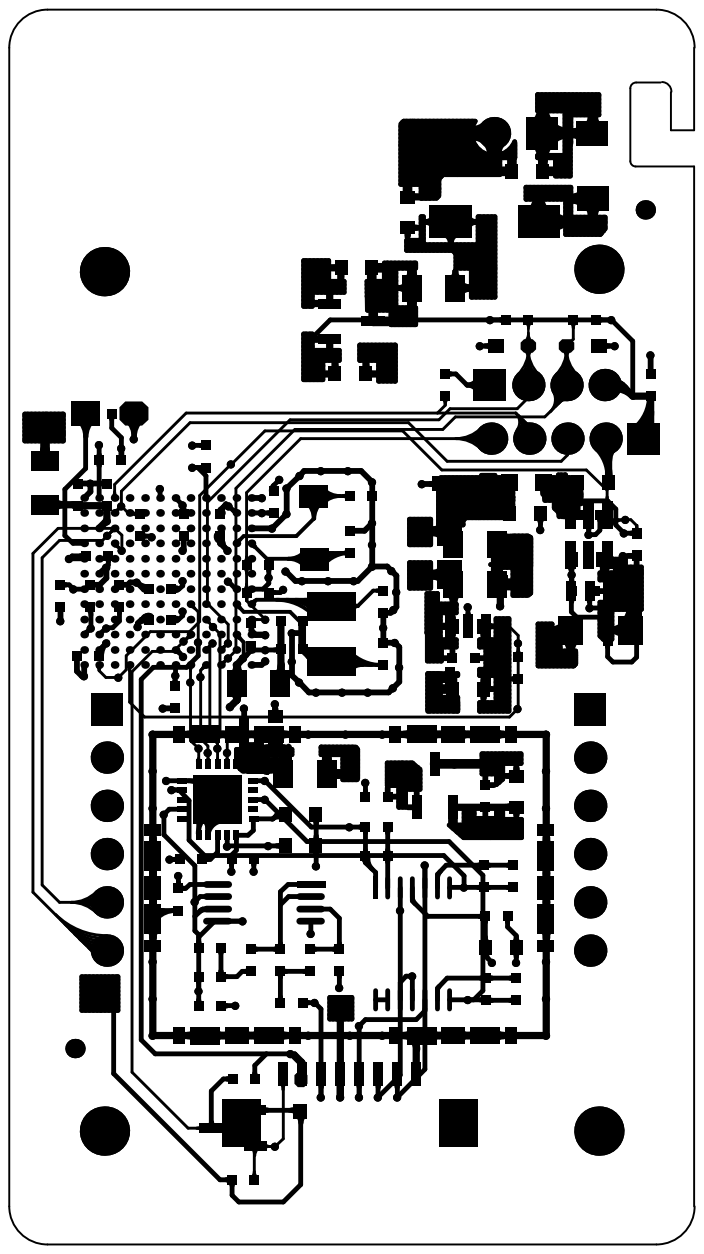
[picture p47: page 2]
