li59533/JunYue_Lora/doc/LORA防爆/03 印制板/LQC7.820.2901-6.pdf

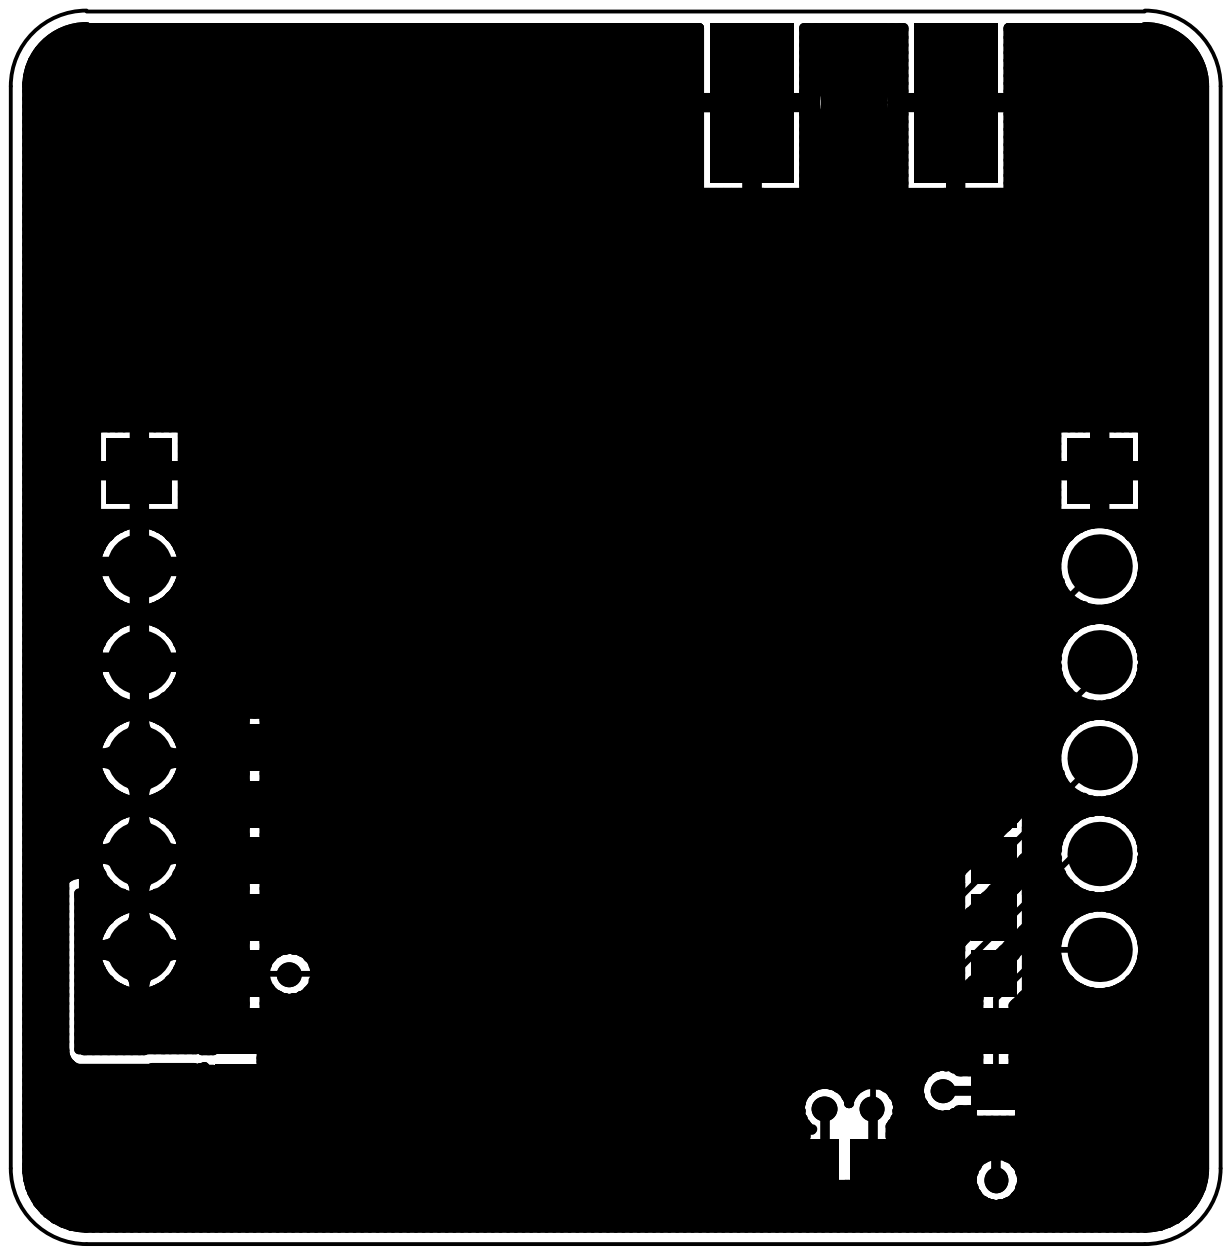
[picture p48: page 1]

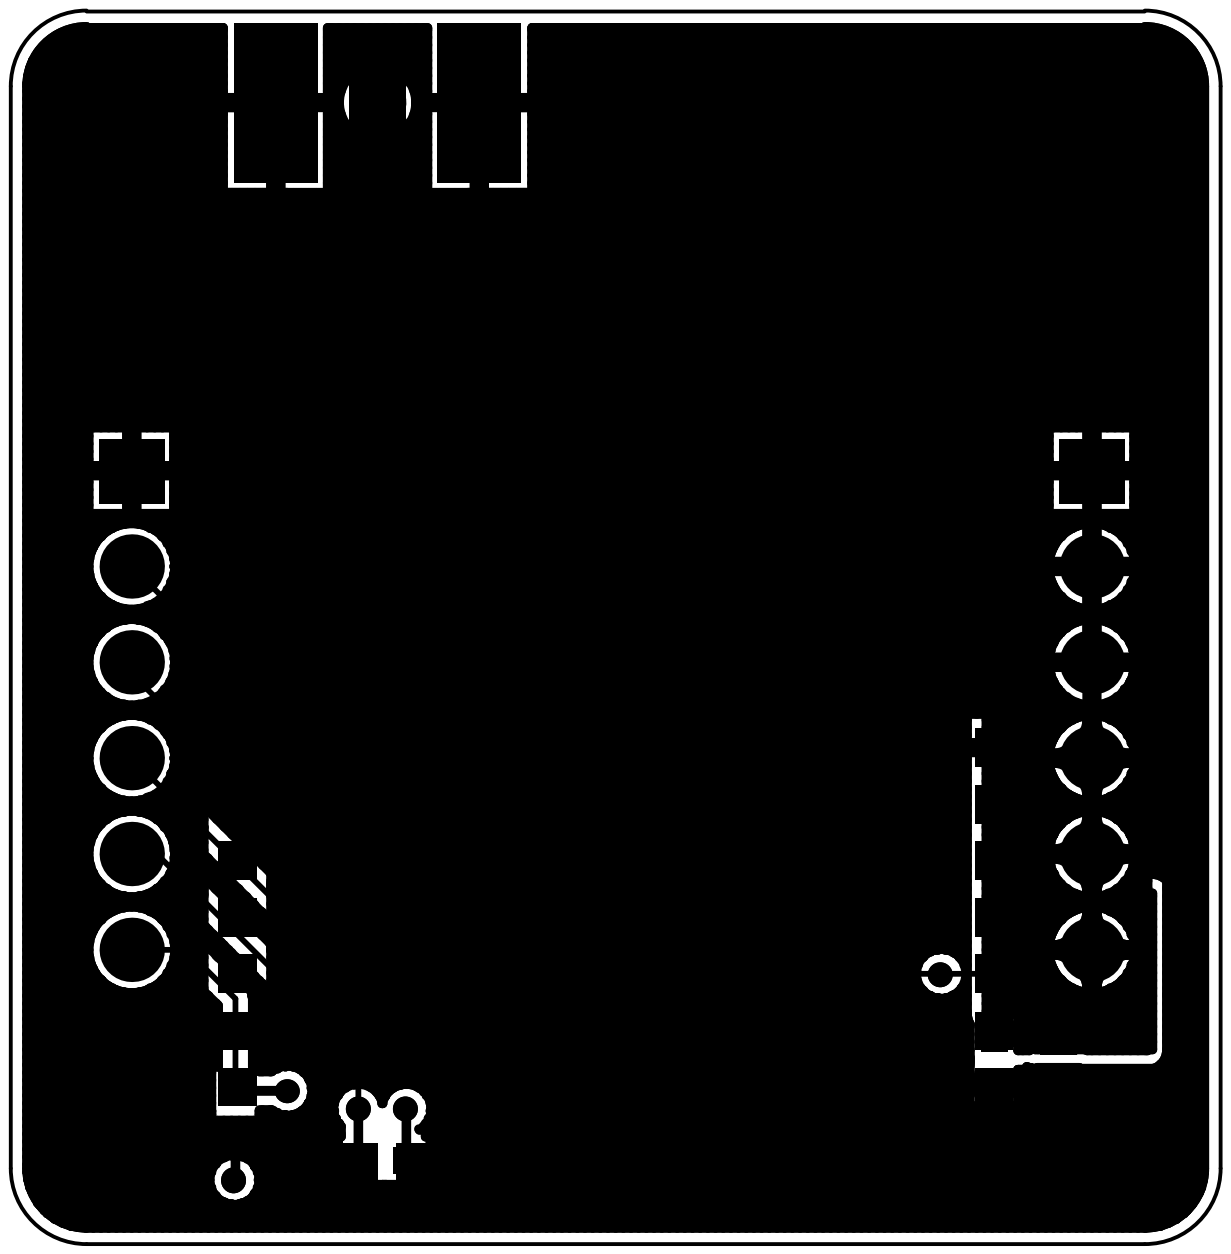
[picture p49: page 2]
