li59533/JunYue_Lora/(list of files, drawings)

Other design files:
doc/PCB20200119/lora mems/底板.PrjPCB
doc/PCB20200119/lora mems/底板.SchDoc
doc/PCB20200119/主板/LORA.PcbLib
doc/PCB20200119/主板/lora.SchDoc
doc/PCB20200119/主板/Schlib1.SchLib
doc/PCB20200119/主板/君悦LORA.PrjPCB
