li59533/JunYue_Lora/doc/stm32l4r9.ioc

Mcu.UserName=STM32L4R9ZIJx
PA5.Signal=SPI1_SCK
PA6.Signal=SPI1_MISO
PA7.Signal=SPI1_MOSI
PB0.Signal=SPI1_NSS
