li59533/JunYue_Lora/code/stm32l4xx/stm32l4xx/projects/stm32l4xx/source/fml/app_led.c

/**
 **************************************************************************************************
 * @file        app_led.c
 * @author
 * @version   v0.1.0
 * @date        
 * @brief
 **************************************************************************************************
 * @attention
 *
 **************************************************************************************************
 */
#include "app_led.h"

/**
 * @addtogroup    XXX 
 * @{  
 */
#include "clog.h"

/**
 * @addtogroup    app_led_Modules 
 * @{  
 */

/**
 * @defgroup      app_led_IO_Defines 
 * @brief         
 * @{  
 */

/**
 * @}
 */

/**
 * @defgroup      app_led_Macros_Defines 
 * @brief         
 * @{  
 */

/**
 * @}
 */
 
/**
 * @defgroup      app_led_Constants_Defines 
 * @brief         
 * @{  
 */

/**
 * @}
 */

/**
 * @defgroup      app_led_Private_Types
 * @brief         
 * @{  
 */

/**
 * @}
 */
 
/**
 * @defgroup      app_led_Private_Variables 
 * @brief         
 * @{  
 */

/**
 * @}
 */
 
/**
 * @defgroup      app_led_Public_Variables 
 * @brief         
 * @{  
 */

/**
 * @}
 */

/**
 * @defgroup      app_led_Private_FunctionPrototypes 
 * @brief         
 * @{  
 */

/**
 * @}
 */

/**
 * @defgroup      app_led_Functions 
 * @brief         
 * @{  
 */

void APP_LED_Work_Rest(void)
{
	
}

/**
 * @}
 */

/**
 * @}
 */

/**
 * @}
 */
