li59533/JunYue_Lora/code/stm32l4xx/stm32l4xx/projects/stm32l4xx/source/fml/app_led.h

/**
 **************************************************************************************************
 * @file        app_led.h
 * @author
 * @version    v0.1.0
 * @date        
 * @brief
 **************************************************************************************************
 * @attention
 *
 **************************************************************************************************
 */
#ifndef _APP_LED_H_
#define _APP_LED_H_

/**
 * @addtogroup    XXX 
 * @{ 
 */
#include "self_def.h"
/**
 * @addtogroup    app_led_Modules 
 * @{  
 */

/**
 * @defgroup      app_led_Exported_Macros 
 * @{  
 */

/**
 * @}
 */

/**
 * @defgroup      app_led_Exported_Constants
 * @{  
 */

/**
 * @}
 */
 
/**
 * @defgroup      app_led_Exported_Types 
 * @{  
 */


/**
 * @}
 */

/**
 * @defgroup      app_led_Exported_Variables 
 * @{  
 */

/**
 * @}
 */

/**
 * @defgroup      app_led_Exported_Functions 
 * @{  
 */

/**
 * @}
 */

/**
 * @}
 */

/**
 * @}
 */
#endif
