li59533/JunYue_Lora/(commit log)

2019-11-22 V0.0.1
    1.添加flash_bsp
2019-11-26 backups
    可以采ad7682
2019-11-28 backups
    完成特征值
2019-12-06 V0.1.0
    1.standby模式
    2.上报，采集通过
    3.
2019-12-11 V0.1.2
    **说明：**
    1.上电2min内，不会休眠。
    2.当休眠时间为0时，不会休眠。
    3.不休眠时，每隔10s上报数据。
    4.支持串口配置。
2020-01-02 V0.1.3
    1.增加拔电池复位电量操作
2020-01-02 V0.1.4
    _修改：_
    1.修复串口接收错位bug
2020-03-13 lora测试代码提交
    lora测试代码提交
    [LORA.PcbLib, Schlib1.SchLib, lora.SchDoc, lora_距离测试_20200120.xlsx, 君悦LORA .xls, 君悦LORA.PrjPCB, 君悦lora_lora模块测试_20200312.xlsx, 底板.PrjPCB]
2020-03-20 测试代码更新
    1.上报主轴有效值
2020-04-01 更新测试代码
    计算RMS
2020-04-23 V0.1.5
    1.更新FFT积分算法
    2.更新峭度算法
    3.智成网络开启说明
2020-05-07 V0.1.6
    1.修改XY轴采集顺序。上报顺序为：ZXY
    2.上报数据后，触发延时休眠
    3.修改LMT01的EN脚，从PE0到PB2
    4.删除TX RX的SWAP功能
    5.波形稳定时间3s
    6.修改NET 接受触发模块复位。
    7.温度读值周期1s
    8.发送次数11000次
    9.对特征值做限制
    10.默认休眠时间10s
    11.上报一些文档
    [abp导入20200506.xlsx, abp导入模板.xls, 君悦LoRa设备记录_20200506.xlsx]
2020-05-07 V0.2.0
    1.修改默认SN：L10031001100
    2.修改默认休眠时间60s
2020-05-08 V0.2.2
    1.修改闪灯机制
    2.串口主动上报数据改为请求上报
2020-05-08 V0.2.3
    1.lora模块发送，2s未响应，重发机制
    2.修改lmt01驱动
    3.未连接底座，温度为-50
2020-05-09 V0.2.4
    1.稳定时间4s
    2.增加串口自动上报开关（1s）
2020-05-09 V0.2.5
    1.重发间隔时间4s
    2.模块开启时间上电（复位）后2s
2020-05-09 V0.2.6
    1.修改串口自动上报数据开关
2020-05-12 V0.2.8
    1.HAL管理休眠，单次定时器改为周期
    2.默认休眠时间改为：10s
2020-05-25 V0.2.9
    1.修改各轴的加速度量程范围
    2.备份文档
    [L100.xls]
2020-08-05 V0.2.10
    1.温度和电量精确小数点1位
    [君悦LoRa设备记录_20200506.xlsx]
